bailwillharr/thecomputer/computer/docs/final_raytrace.png

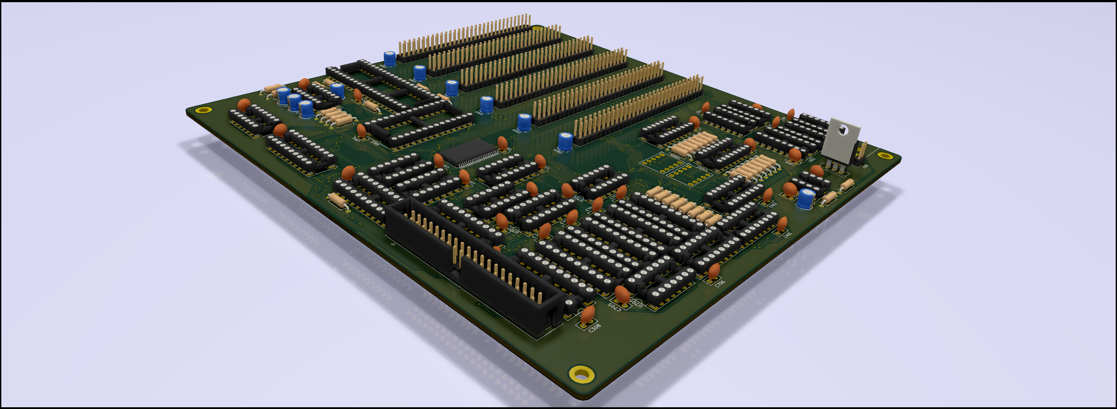
computer/docs/final_raytrace.png
