bailwillharr/thecomputer/computer/docs/final_raytrace3.png

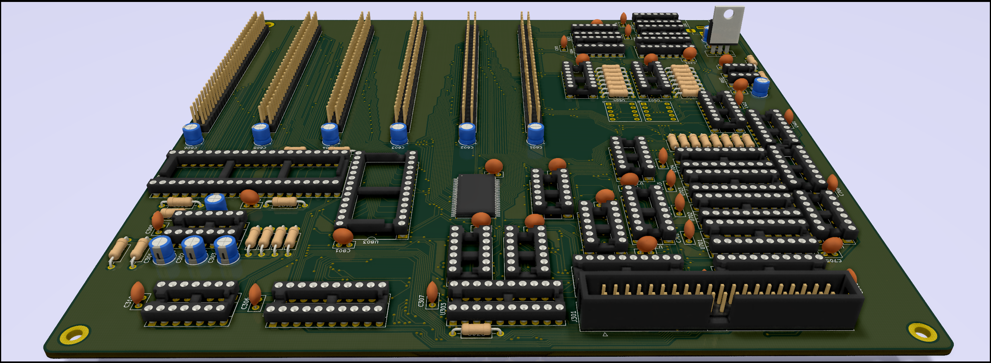
computer/docs/final_raytrace3.png
