bailwillharr/thecomputer/computer/docs/final_raytrace2.png

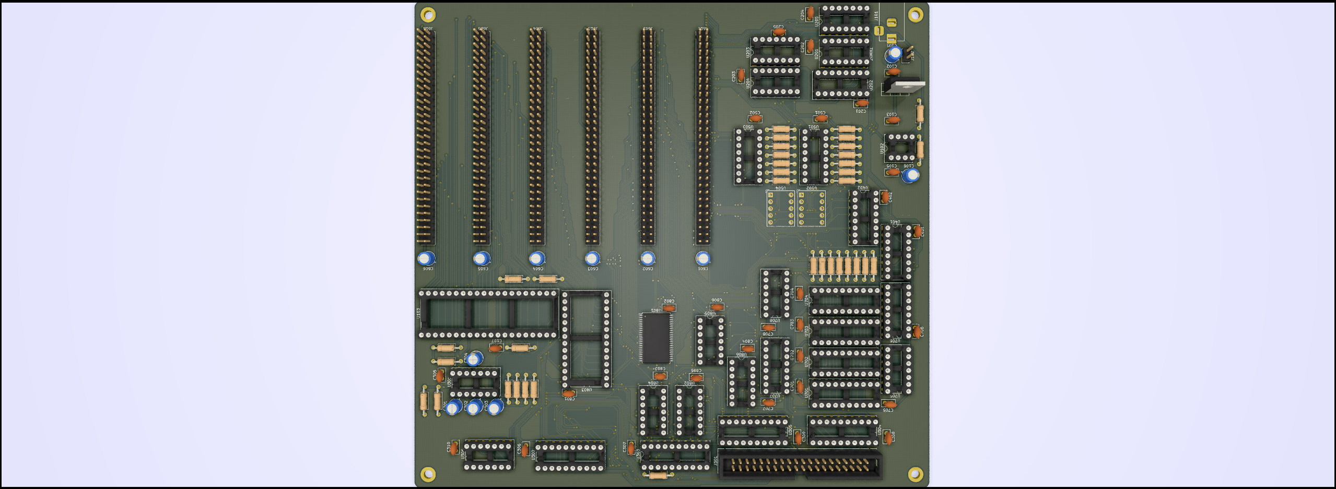
computer/docs/final_raytrace2.png
