bailwillharr/thecomputer/video/docs/plan.png

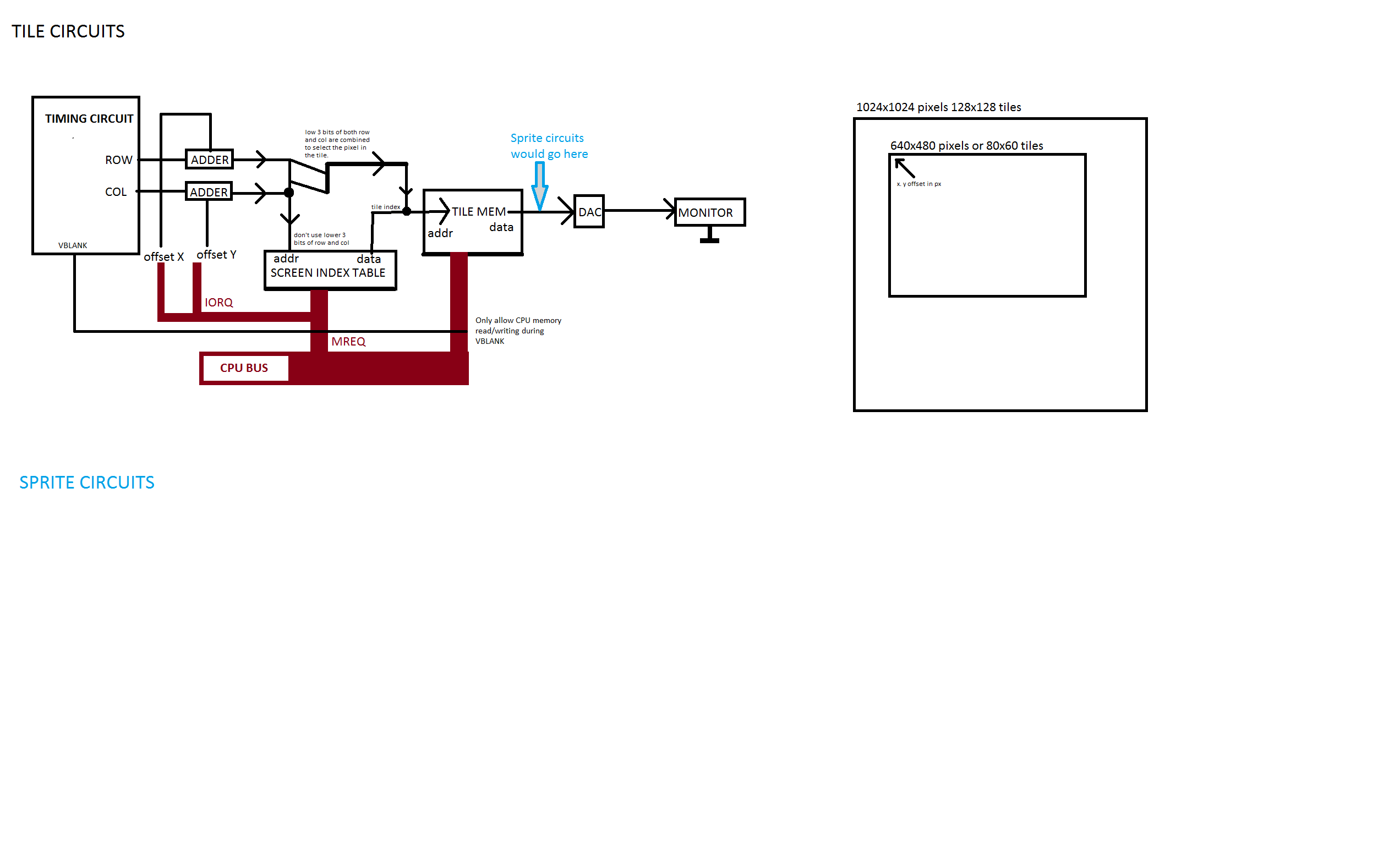
video/docs/plan.png
