bailwillharr/thecomputer/video/video.pdf

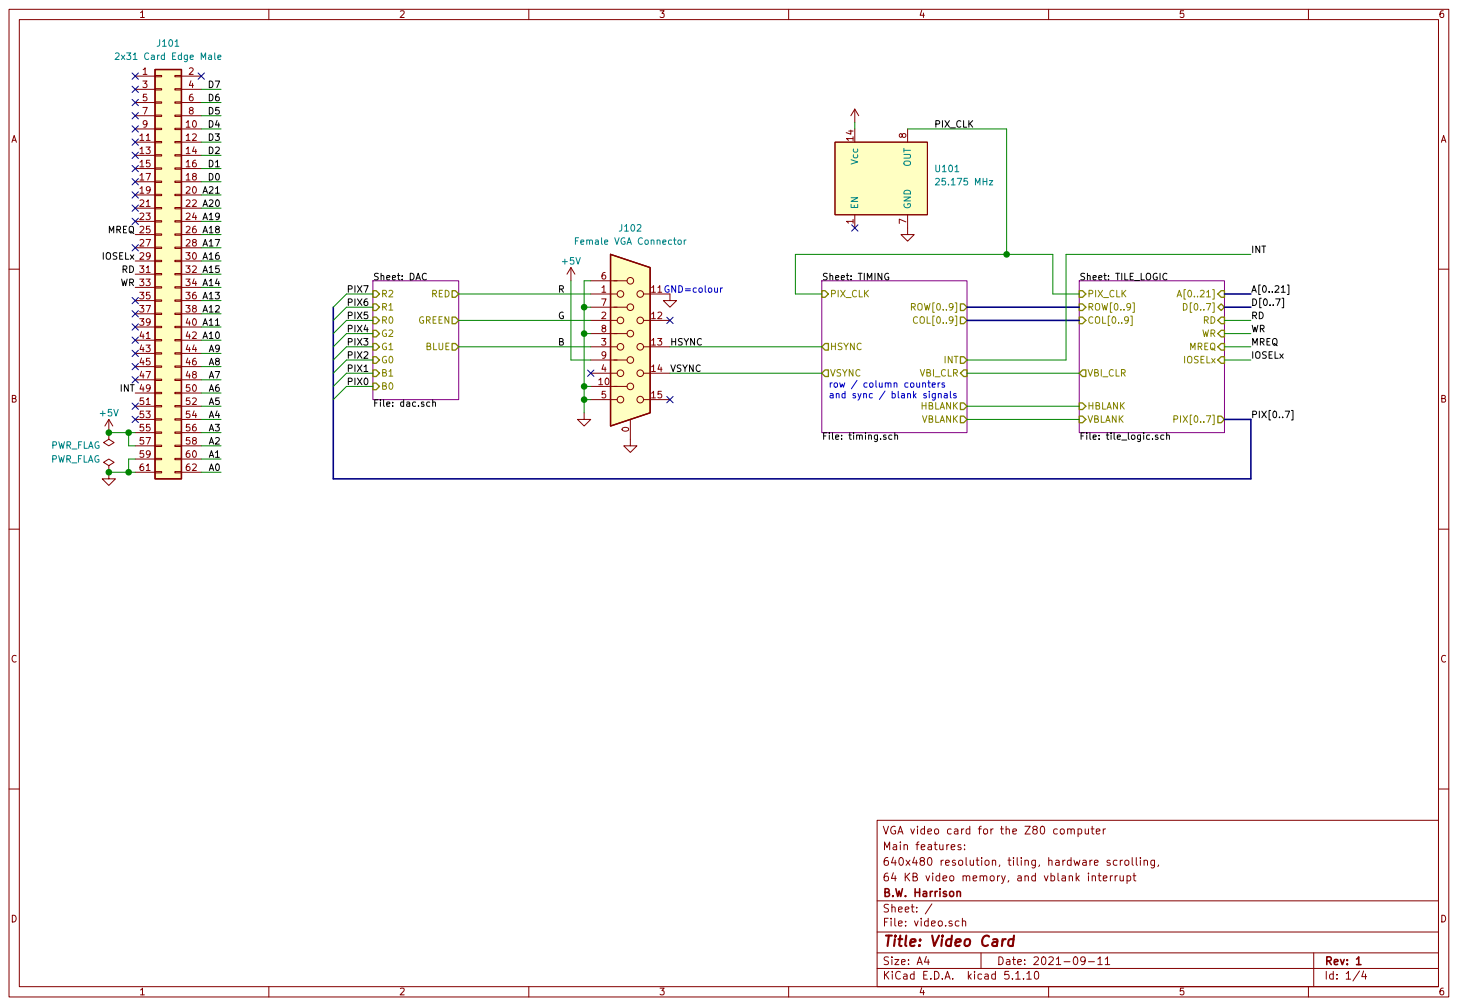
[picture p5: page 1]

row / column counters and sync / blank signals GND=colour

640x480 resolution, tiling, hardware scrolling, Main features: VGA video card for the Z80 computer

64 KB video memory, and vblank interrupt
File: video.sch Sheet: / B.W. Harrison

Id: 1/4 Title: Video Card

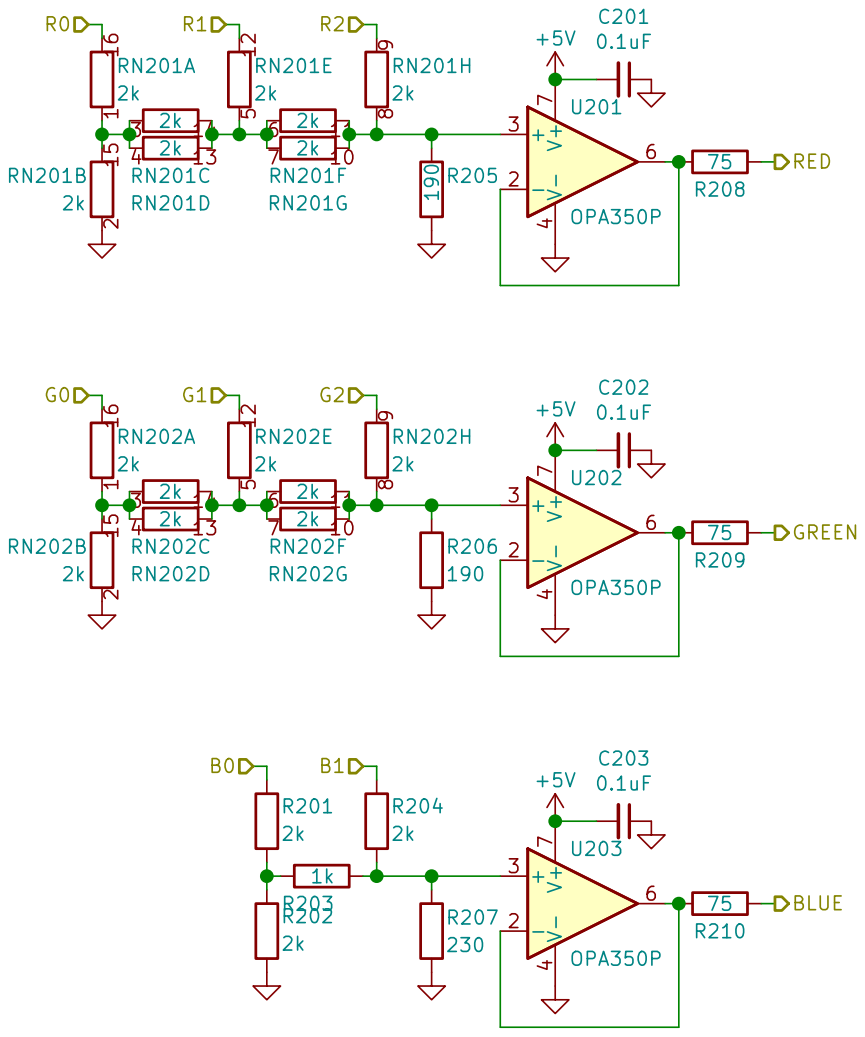
[picture p6: page 2]

Id: 2/4 Title: File: dac.sch Sheet: /DAC/ R204

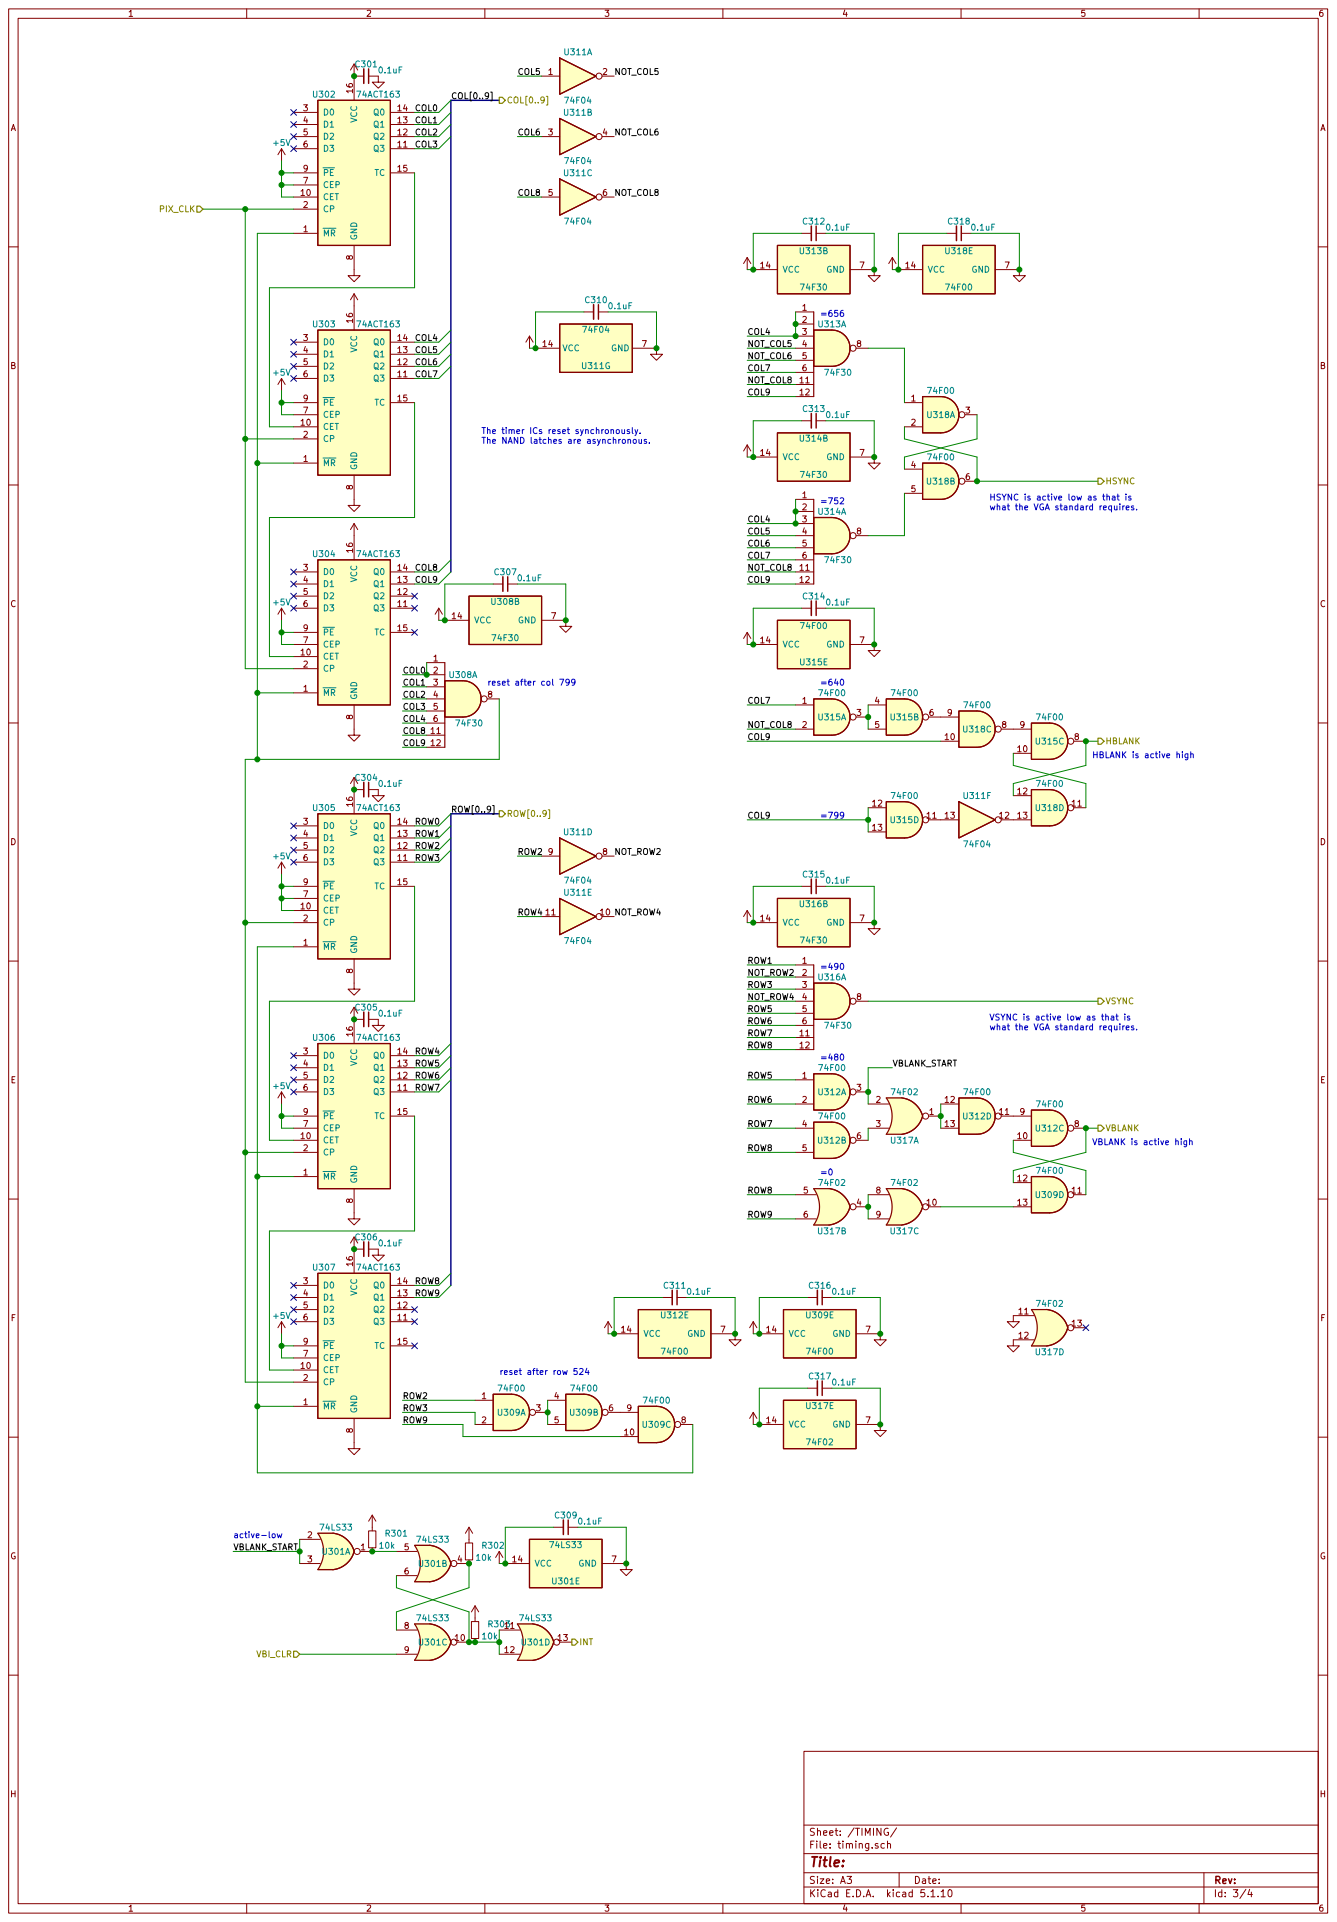
[picture p7: page 3]

8 PE 9 U302 74ACT163 MR 1 CET 10 Q3 11 Q2 12 Q1 13 Q0 14 TC 15 VCC 16 CP 2 D0 3 D1 4 D2 5 D3 6 CEP 7 GND

8 PE 9 U304 74ACT163 MR 1 CET 10 Q3 11 Q2 12 Q1 13 Q0 14 TC 15 VCC 16 CP 2 D0 3 D1 4 D2 5 D3 6 CEP 7 GND

8 PE 9 U306 74ACT163 MR 1 CET 10 Q3 11 Q2 12 Q1 13 Q0 14 TC 15 VCC 16 CP 2 D0 3 D1 4 D2 5 D3 6 CEP 7 GND

8 PE 9 U305 74ACT163 MR 1 CET 10 Q3 11 Q2 12 Q1 13 Q0 14 TC 15 VCC 16 CP 2 D0 3 D1 4 D2 5 D3 6 CEP 7 GND

Id: 3/4 Title: File: timing.sch Sheet: /TIMING/

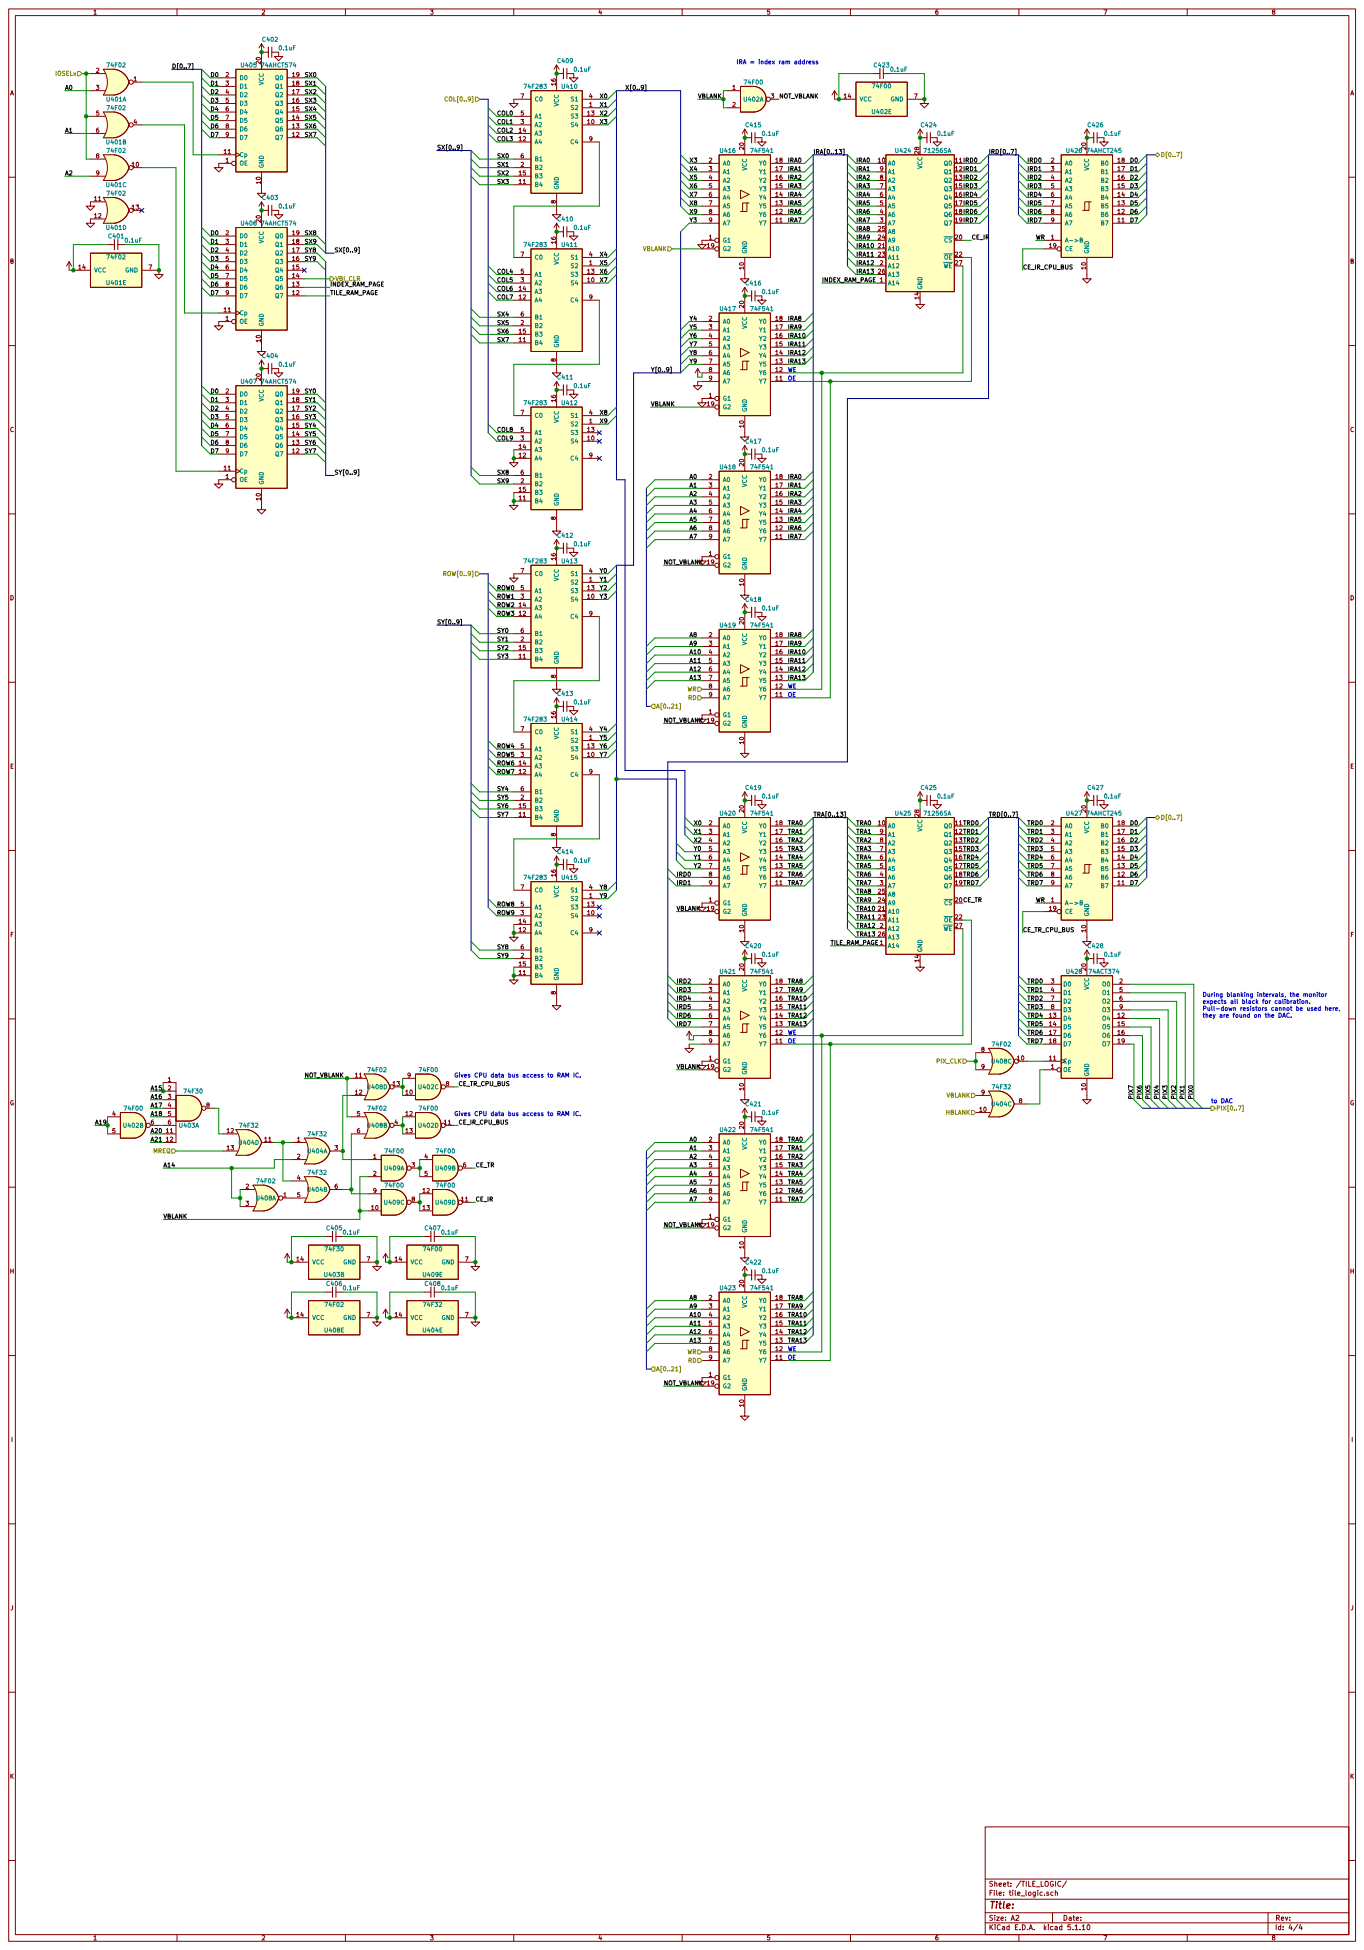
[picture p8: page 4]

IRA = index ram address

During blanking intervals, the monitor expects all black for calibration. Pull-down resistors cannot be used here,

they are found on the DAC. Gives CPU data bus access to RAM IC. Gives CPU data bus access to RAM IC.

to DAC WE OEWE OE

Id: 4/4 Title: File: tile_logic.sch Sheet: /TILE_LOGIC/
