bailwillharr/thecomputer/computer/pcb.pdf

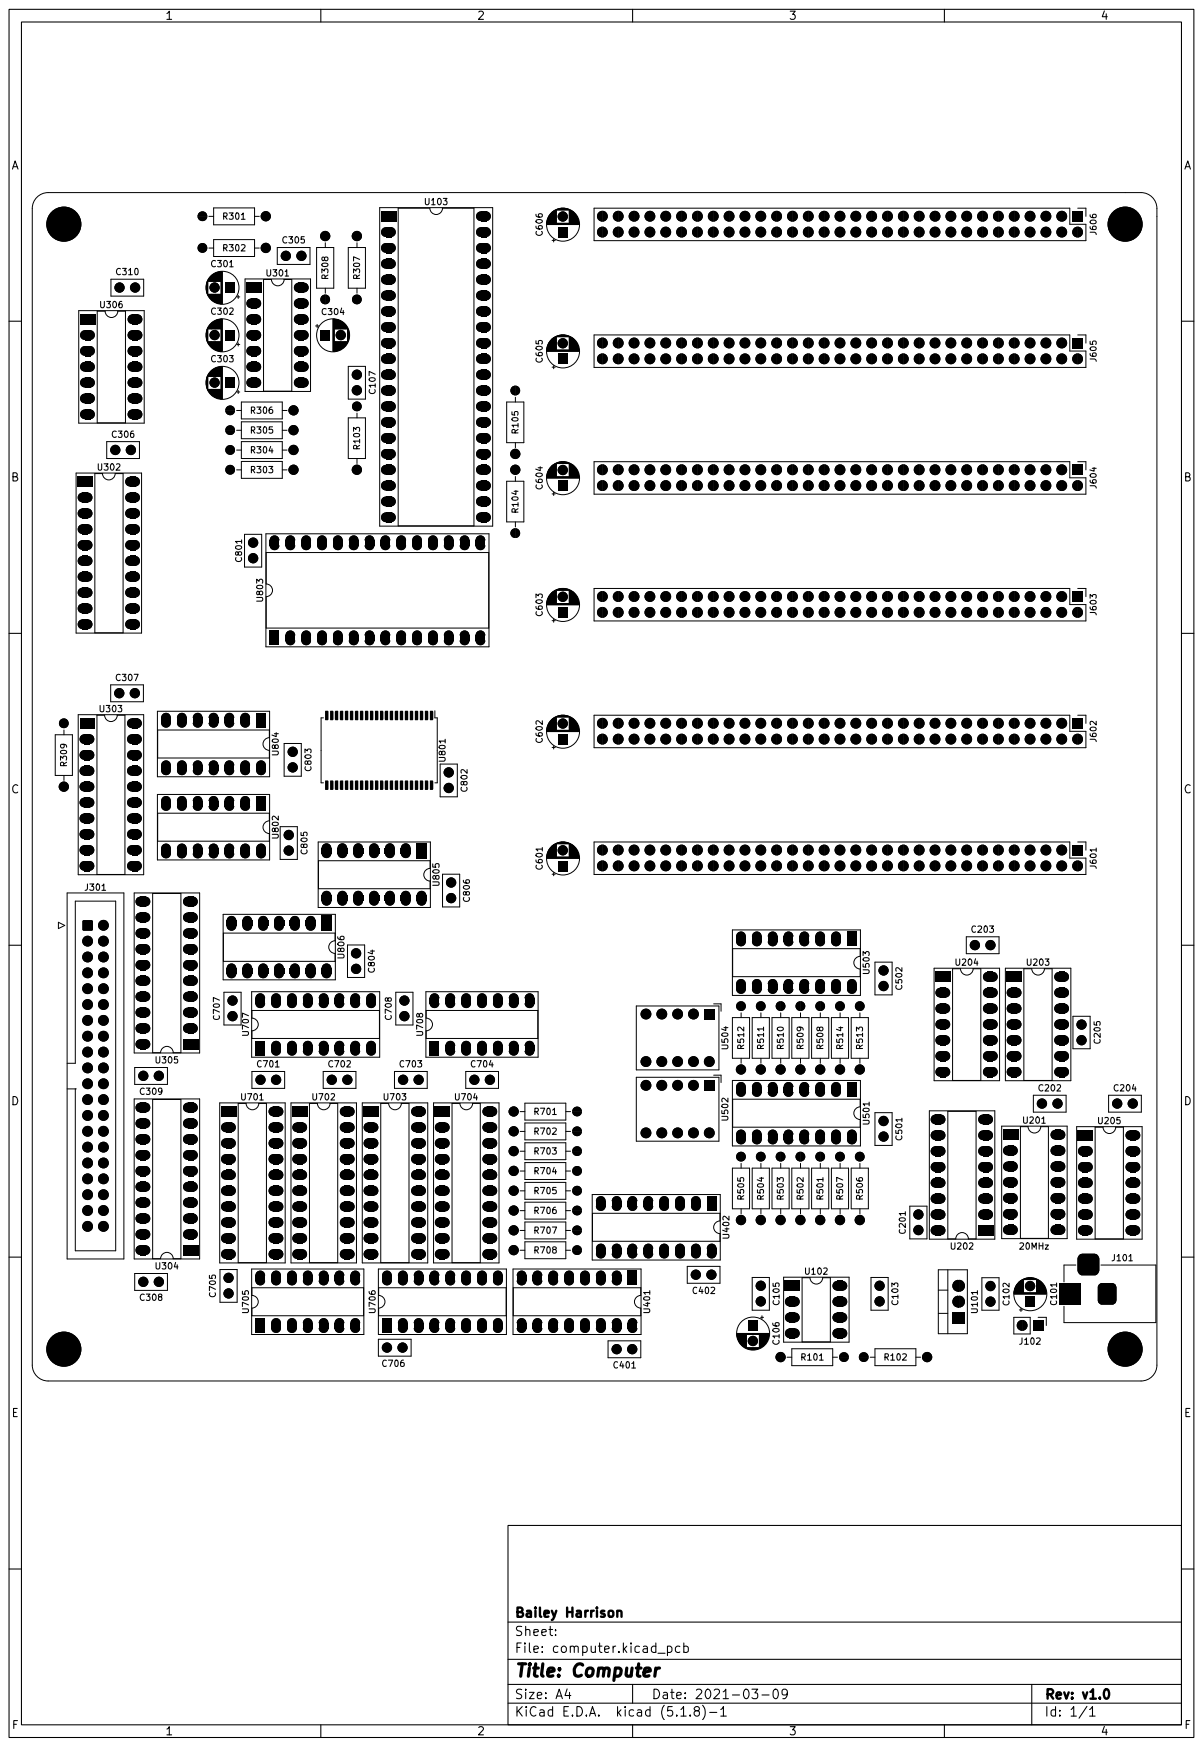
[picture p17: page 1]
