bailwillharr/thecomputer/video/video.kicad_pcb

## KiCad design video/video.kicad_pcb (2023-03-09)

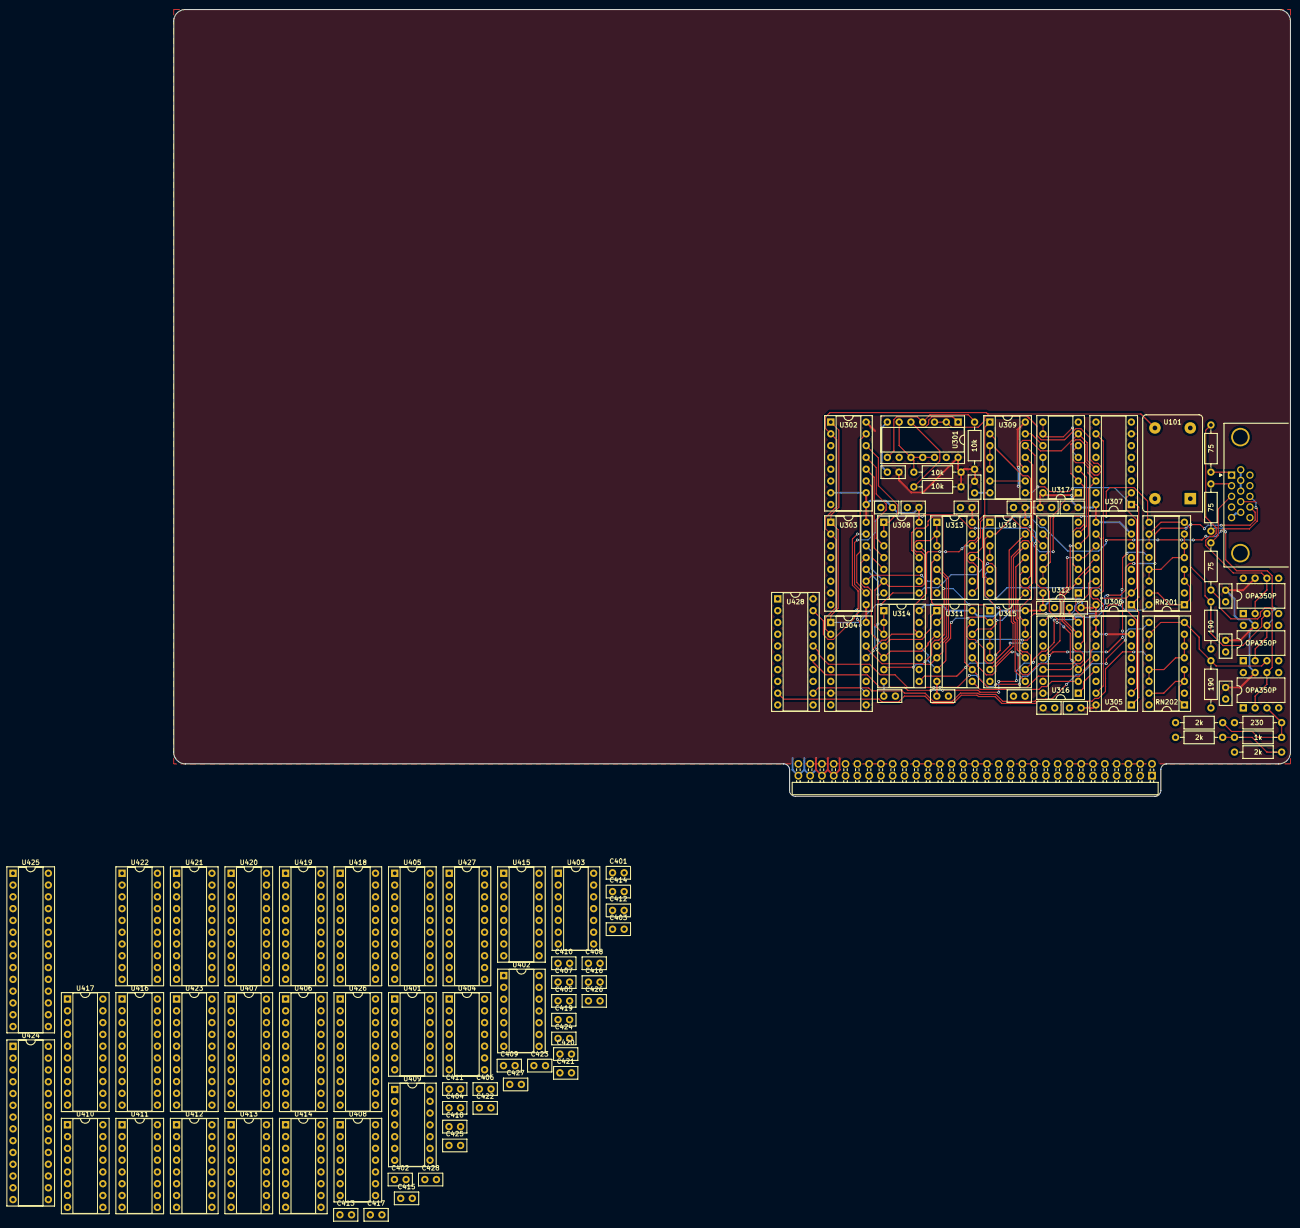
[picture p18: board video.kicad_pcb from above]

Board: 2 copper layers, 240.7 x 169.5 mm, 112 parts (0 on the bottom side), 213 nets.

Parts:
C201, C202, C203, C301, C304, C305, C306, C307, C309, C310, C311, C312, C313, C314, C315, C316, C317, C318, C401, C402, C403, C404, C405, C406, C407, C408, C409, C410, C411, C412, C413, C414, C415, C416, C417, C418, C419, C420, C421, C422, C423, C424, C425, C426, C427, C428: 0.1uF; C_Disc_D5.0mm_W2.5mm_P2.50mm
J101: 2x31 Card Edge Male; PinHeader_2x31_P2.54mm_Horizontal_AltPins
J102: Female VGA Connector; DSUB-15-HD_Female_Horizontal_P2.29x1.98mm_EdgePinOffset8.35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
R201, R202, R204: 2k; R_Axial_DIN0207_L6.3mm_D2.5mm_P10.16mm_Horizontal
R203: 1k; R_Axial_DIN0207_L6.3mm_D2.5mm_P10.16mm_Horizontal
R205, R206: 190; R_Axial_DIN0207_L6.3mm_D2.5mm_P10.16mm_Horizontal
R207: 230; R_Axial_DIN0207_L6.3mm_D2.5mm_P10.16mm_Horizontal
R208, R209, R210: 75; R_Axial_DIN0207_L6.3mm_D2.5mm_P10.16mm_Horizontal
R301, R302, R303: 10k; R_Axial_DIN0207_L6.3mm_D2.5mm_P10.16mm_Horizontal
RN201, RN202: 2k; DIP-16_W7.62mm_Socket
U101: 25.175 MHz; Oscillator_DIP-14_LargePads
U201, U202, U203: OPA350P; DIP-8_W7.62mm
U301: 74LS33; DIP-14_W7.62mm_Socket
U302, U303, U304, U305, U306, U307: 74ACT163; DIP-16_W7.62mm_Socket
U308, U313, U314, U316, U403: 74F30; DIP-14_W7.62mm_Socket
U309, U312, U315, U318, U402, U409: 74F00; DIP-14_W7.62mm_Socket
U311: 74F04; DIP-14_W7.62mm_Socket
U317, U401, U408: 74F02; DIP-14_W7.62mm_Socket
U404: 74F32; DIP-14_W7.62mm_Socket
U405, U406, U407: 74AHCT574; DIP-20_W7.62mm_Socket
U410, U411, U412, U413, U414, U415: 74F283; DIP-16_W7.62mm_Socket
U416, U417, U418, U419, U420, U421, U422, U423: 74F541; DIP-20_W7.62mm_Socket
U424, U425: 71256SA; DIP-28_W7.62mm_Socket
U426, U427: 74AHCT245; DIP-20_W7.62mm_Socket
U428: 74ACT374; DIP-20_W7.62mm_Socket

Connections:
+5V: C201.2, C202.2, C203.2, C301.2, C304.2, C305.2, C306.2, C307.2, C309.2, C310.2, C311.2, C312.2, C313.2, C314.2, C315.2, C316.2, C317.2, C318.2, C401.2, C402.2, C403.2, C404.2, C405.2, C406.2, C407.2, C408.2, C409.2, C410.2, C411.2, C412.2, C413.2, C414.2, C415.2, C416.2, C417.2, C418.2, C419.2, C420.2, C421.2, C422.2, C423.2, C424.2, C425.2, C426.2, C427.2, C428.2, J101.55, J101.57, J102.9, R301.1, R302.1, R303.1, U101.14 (Vcc), U201.7 (V+), U202.7 (V+), U203.7 (V+), U301.14 (VCC), U302.7 (CEP), U302.9 (~PE), U302.10 (CET), U302.16 (VCC), U303.7 (CEP), U303.9 (~PE), U303.16 (VCC), U304.7 (CEP), U304.9 (~PE), U304.16 (VCC), U305.7 (CEP), U305.9 (~PE), U305.10 (CET), U305.16 (VCC), U306.7 (CEP), U306.9 (~PE), U306.16 (VCC), U307.7 (CEP), U307.9 (~PE), U307.16 (VCC), U308.14 (VCC), U309.14 (VCC), U311.14 (VCC), U312.14 (VCC), U313.14 (VCC), U314.14 (VCC), U315.14 (VCC), U316.14 (VCC), U317.14 (VCC), U318.14 (VCC), U401.14 (VCC), U402.14 (VCC), U403.14 (VCC), U404.14 (VCC), U405.20 (VCC), U406.20 (VCC), U407.20 (VCC), U408.14 (VCC), U409.14 (VCC), U410.16 (VCC), U411.16 (VCC), U412.16 (VCC), U413.16 (VCC), U414.16 (VCC), U415.16 (VCC), U416.20 (VCC), U417.8 (A6), U417.20 (VCC), U418.20 (VCC), U419.20 (VCC), U420.20 (VCC), U421.8 (A6), U421.20 (VCC), U422.20 (VCC), U423.20 (VCC), U424.28 (VCC), U425.28 (VCC), U426.20 (VCC), U427.20 (VCC), U428.20 (VCC)
/A0: J101.62, U401.3, U418.2 (A0), U422.2 (A0)
/A1: J101.60, U401.6, U418.3 (A1), U422.3 (A1)
/A2: J101.58, U401.9, U418.4 (A2), U422.4 (A2)
/A3: J101.56, U418.5 (A3), U422.5 (A3)
/A4: J101.54, U418.6 (A4), U422.6 (A4)
/A5: J101.52, U418.7 (A5), U422.7 (A5)
/A6: J101.50, U418.8 (A6), U422.8 (A6)
/A7: J101.48, U418.9 (A7), U422.9 (A7)
/A8: J101.46, U419.2 (A0), U423.2 (A0)
/A9: J101.44, U419.3 (A1), U423.3 (A1)
/A10: J101.42, U419.4 (A2), U423.4 (A2)
/A11: J101.40, U419.5 (A3), U423.5 (A3)
/A12: J101.38, U419.6 (A4), U423.6 (A4)
/A13: J101.36, U419.7 (A5), U423.7 (A5)
/A14: J101.34, U404.2, U408.2, U408.3
/A15: J101.32, U403.1, U403.2
/A16: J101.30, U403.3
/A17: J101.28, U403.4
/A18: J101.26, U403.5
/A19: J101.24, U402.4, U402.5
/A20: J101.22, U403.11
/A21: J101.20, U403.12
/B: J102.3, R210.1
/D0: J101.18, U405.2 (D0), U406.2 (D0), U407.2 (D0), U426.18 (B0), U427.18 (B0)
/D1: J101.16, U405.3 (D1), U406.3 (D1), U407.3 (D1), U426.17 (B1), U427.17 (B1)
/D2: J101.14, U405.4 (D2), U406.4 (D2), U407.4 (D2), U426.16 (B2), U427.16 (B2)
/D3: J101.12, U405.5 (D3), U406.5 (D3), U407.5 (D3), U426.15 (B3), U427.15 (B3)
/D4: J101.10, U405.6 (D4), U406.6 (D4), U407.6 (D4), U426.14 (B4), U427.14 (B4)
/D5: J101.8, U405.7 (D5), U406.7 (D5), U407.7 (D5), U426.13 (B5), U427.13 (B5)
/D6: J101.6, U405.8 (D6), U406.8 (D6), U407.8 (D6), U426.12 (B6), U427.12 (B6)
/D7: J101.4, U405.9 (D7), U406.9 (D7), U407.9 (D7), U426.11 (B7), U427.11 (B7)
/G: J102.2, R209.1
/HSYNC: J102.13, U318.2, U318.6
/INT: J101.49, U301.13
/IOSELx: J101.29, U401.2, U401.5, U401.8
/MREQ: J101.25, U404.13
/PIX0: R201.2, U428.2 (O0)
/PIX1: R204.2, U428.5 (O1)
/PIX2: RN202.16 (R1.2), U428.6 (O2)
/PIX3: RN202.12 (R5.2), U428.9 (O3)
/PIX4: RN202.9 (R8.2), U428.12 (O4)
/PIX5: RN201.16 (R1.2), U428.15 (O5)
/PIX6: RN201.12 (R5.2), U428.16 (O6)
/PIX7: RN201.9 (R8.2), U428.19 (O7)
/PIX_CLK: U101.8 (OUT), U302.2 (CP), U303.2 (CP), U304.2 (CP), U408.8, U408.9
/R: J102.1, R208.1
/RD: J101.31, U419.9 (A7), U423.9 (A7)
/TILE_LOGIC/CE_IR: U409.11, U424.20 (~CS)
/TILE_LOGIC/CE_IR_CPU_BUS: U402.11, U426.19 (CE)
/TILE_LOGIC/CE_TR: U409.6, U425.20 (~CS)
/TILE_LOGIC/CE_TR_CPU_BUS: U402.8, U427.19 (CE)
/TILE_LOGIC/HBLANK: U315.8, U318.12, U404.10
/TILE_LOGIC/INDEX_RAM_PAGE: U406.13 (Q6), U424.1 (A14)
/TILE_LOGIC/IRA0: U416.18 (Y0), U418.18 (Y0), U424.10 (A0)
/TILE_LOGIC/IRA1: U416.17 (Y1), U418.17 (Y1), U424.9 (A1)
/TILE_LOGIC/IRA2: U416.16 (Y2), U418.16 (Y2), U424.8 (A2)
/TILE_LOGIC/IRA3: U416.15 (Y3), U418.15 (Y3), U424.7 (A3)
/TILE_LOGIC/IRA4: U416.14 (Y4), U418.14 (Y4), U424.6 (A4)
/TILE_LOGIC/IRA5: U416.13 (Y5), U418.13 (Y5), U424.5 (A5)
/TILE_LOGIC/IRA6: U416.12 (Y6), U418.12 (Y6), U424.4 (A6)
/TILE_LOGIC/IRA7: U416.11 (Y7), U418.11 (Y7), U424.3 (A7)
/TILE_LOGIC/IRA8: U417.18 (Y0), U419.18 (Y0), U424.25 (A8)
/TILE_LOGIC/IRA9: U417.17 (Y1), U419.17 (Y1), U424.24 (A9)
/TILE_LOGIC/IRA10: U417.16 (Y2), U419.16 (Y2), U424.21 (A10)
/TILE_LOGIC/IRA11: U417.15 (Y3), U419.15 (Y3), U424.23 (A11)
/TILE_LOGIC/IRA12: U417.14 (Y4), U419.14 (Y4), U424.2 (A12)
/TILE_LOGIC/IRA13: U417.13 (Y5), U419.13 (Y5), U424.26 (A13)
/TILE_LOGIC/IRD0: U420.8 (A6), U424.11 (Q0), U426.2 (A0)
/TILE_LOGIC/IRD1: U420.9 (A7), U424.12 (Q1), U426.3 (A1)
/TILE_LOGIC/IRD2: U421.2 (A0), U424.13 (Q2), U426.4 (A2)
/TILE_LOGIC/IRD3: U421.3 (A1), U424.15 (Q3), U426.5 (A3)
/TILE_LOGIC/IRD4: U421.4 (A2), U424.16 (Q4), U426.6 (A4)
/TILE_LOGIC/IRD5: U421.5 (A3), U424.17 (Q5), U426.7 (A5)
/TILE_LOGIC/IRD6: U421.6 (A4), U424.18 (Q6), U426.8 (A6)
/TILE_LOGIC/IRD7: U421.7 (A5), U424.19 (Q7), U426.9 (A7)
/TILE_LOGIC/NOT_VBLANK: U402.3, U408.5, U408.11, U418.19 (G2), U419.19 (G2), U422.19 (G2), U423.19 (G2)
/TILE_LOGIC/SX0: U405.19 (Q0), U410.6 (B1)
/TILE_LOGIC/SX1: U405.18 (Q1), U410.2 (B2)
/TILE_LOGIC/SX2: U405.17 (Q2), U410.15 (B3)
/TILE_LOGIC/SX3: U405.16 (Q3), U410.11 (B4)
/TILE_LOGIC/SX4: U405.15 (Q4), U411.6 (B1)
/TILE_LOGIC/SX5: U405.14 (Q5), U411.2 (B2)
/TILE_LOGIC/SX6: U405.13 (Q6), U411.15 (B3)
/TILE_LOGIC/SX7: U405.12 (Q7), U411.11 (B4)
/TILE_LOGIC/SX8: U406.19 (Q0), U412.6 (B1)
/TILE_LOGIC/SX9: U406.18 (Q1), U412.2 (B2)
/TILE_LOGIC/SY0: U407.19 (Q0), U413.6 (B1)
/TILE_LOGIC/SY1: U407.18 (Q1), U413.2 (B2)
/TILE_LOGIC/SY2: U407.17 (Q2), U413.15 (B3)
/TILE_LOGIC/SY3: U407.16 (Q3), U413.11 (B4)
/TILE_LOGIC/SY4: U407.15 (Q4), U414.6 (B1)
/TILE_LOGIC/SY5: U407.14 (Q5), U414.2 (B2)
/TILE_LOGIC/SY6: U407.13 (Q6), U414.15 (B3)
/TILE_LOGIC/SY7: U407.12 (Q7), U414.11 (B4)
/TILE_LOGIC/SY8: U406.17 (Q2), U415.6 (B1)
/TILE_LOGIC/SY9: U406.16 (Q3), U415.2 (B2)
/TILE_LOGIC/TILE_RAM_PAGE: U406.12 (Q7), U425.1 (A14)
/TILE_LOGIC/TRA0: U420.18 (Y0), U422.18 (Y0), U425.10 (A0)
/TILE_LOGIC/TRA1: U420.17 (Y1), U422.17 (Y1), U425.9 (A1)
/TILE_LOGIC/TRA2: U420.16 (Y2), U422.16 (Y2), U425.8 (A2)
/TILE_LOGIC/TRA3: U420.15 (Y3), U422.15 (Y3), U425.7 (A3)
/TILE_LOGIC/TRA4: U420.14 (Y4), U422.14 (Y4), U425.6 (A4)
/TILE_LOGIC/TRA5: U420.13 (Y5), U422.13 (Y5), U425.5 (A5)
/TILE_LOGIC/TRA6: U420.12 (Y6), U422.12 (Y6), U425.4 (A6)
/TILE_LOGIC/TRA7: U420.11 (Y7), U422.11 (Y7), U425.3 (A7)
/TILE_LOGIC/TRA8: U421.18 (Y0), U423.18 (Y0), U425.25 (A8)
/TILE_LOGIC/TRA9: U421.17 (Y1), U423.17 (Y1), U425.24 (A9)
/TILE_LOGIC/TRA10: U421.16 (Y2), U423.16 (Y2), U425.21 (A10)
/TILE_LOGIC/TRA11: U421.15 (Y3), U423.15 (Y3), U425.23 (A11)
/TILE_LOGIC/TRA12: U421.14 (Y4), U423.14 (Y4), U425.2 (A12)
/TILE_LOGIC/TRA13: U421.13 (Y5), U423.13 (Y5), U425.26 (A13)
/TILE_LOGIC/TRD0: U425.11 (Q0), U427.2 (A0), U428.3 (D0)
/TILE_LOGIC/TRD1: U425.12 (Q1), U427.3 (A1), U428.4 (D1)
/TILE_LOGIC/TRD2: U425.13 (Q2), U427.4 (A2), U428.7 (D2)
/TILE_LOGIC/TRD3: U425.15 (Q3), U427.5 (A3), U428.8 (D3)
/TILE_LOGIC/TRD4: U425.16 (Q4), U427.6 (A4), U428.13 (D4)
/TILE_LOGIC/TRD5: U425.17 (Q5), U427.7 (A5), U428.14 (D5)
/TILE_LOGIC/TRD6: U425.18 (Q6), U427.8 (A6), U428.17 (D6)
/TILE_LOGIC/TRD7: U425.19 (Q7), U427.9 (A7), U428.18 (D7)
/TILE_LOGIC/VBI_CLR: U301.9, U406.14 (Q5)
/TILE_LOGIC/VBLANK: U309.12, U312.8, U402.1, U402.2, U404.9, U409.2, U409.10, U416.19 (G2), U417.19 (G2), U420.19 (G2), U421.19 (G2)
/TILE_LOGIC/X0: U410.4 (S1), U420.2 (A0)
/TILE_LOGIC/X1: U410.1 (S2), U420.3 (A1)
/TILE_LOGIC/X2: U410.13 (S3), U420.4 (A2)
/TILE_LOGIC/X3: U410.10 (S4), U416.2 (A0)
/TILE_LOGIC/X4: U411.4 (S1), U416.3 (A1)
/TILE_LOGIC/X5: U411.1 (S2), U416.4 (A2)
/TILE_LOGIC/X6: U411.13 (S3), U416.5 (A3)
/TILE_LOGIC/X7: U411.10 (S4), U416.6 (A4)
/TILE_LOGIC/X8: U412.4 (S1), U416.7 (A5)
/TILE_LOGIC/X9: U412.1 (S2), U416.8 (A6)
/TILE_LOGIC/Y0: U413.4 (S1), U420.5 (A3)
/TILE_LOGIC/Y1: U413.1 (S2), U420.6 (A4)
/TILE_LOGIC/Y2: U413.13 (S3), U420.7 (A5)
/TILE_LOGIC/Y3: U413.10 (S4), U416.9 (A7)
/TILE_LOGIC/Y4: U414.4 (S1), U417.2 (A0)
/TILE_LOGIC/Y5: U414.1 (S2), U417.3 (A1)
/TILE_LOGIC/Y6: U414.13 (S3), U417.4 (A2)
/TILE_LOGIC/Y7: U414.10 (S4), U417.5 (A3)
/TILE_LOGIC/Y8: U415.4 (S1), U417.6 (A4)
/TILE_LOGIC/Y9: U415.1 (S2), U417.7 (A5)
/TIMING/COL0: U308.1, U308.2, U410.5 (A1)
/TIMING/COL1: U308.3, U410.3 (A2)
/TIMING/COL2: U308.4, U410.14 (A3)
/TIMING/COL3: U308.5, U410.12 (A4)
/TIMING/COL4: U308.6, U313.1, U313.2, U313.3, U314.1, U314.2, U314.3, U411.5 (A1)
/TIMING/COL5: U311.1, U314.4, U411.3 (A2)
/TIMING/COL6: U311.3, U314.5, U411.14 (A3)
/TIMING/COL7: U313.6, U314.6, U315.1, U411.12 (A4)
/TIMING/COL8: U308.11, U311.5, U412.5 (A1)
/TIMING/COL9: U308.12, U313.12, U314.12, U315.12, U315.13, U318.10, U412.3 (A2)
/TIMING/NOT_COL5: U311.2, U313.4
/TIMING/NOT_COL6: U311.4, U313.5
/TIMING/NOT_COL8: U311.6, U313.11, U314.11, U315.2
/TIMING/NOT_ROW2: U311.8, U316.2
/TIMING/NOT_ROW4: U311.10, U316.4
/TIMING/ROW1: U316.1, U413.3 (A2)
/TIMING/ROW2: U309.1, U311.9, U413.14 (A3)
/TIMING/ROW3: U309.2, U316.3, U413.12 (A4)
/TIMING/ROW4: U311.11, U414.5 (A1)
/TIMING/ROW5: U312.1, U316.5, U414.3 (A2)
/TIMING/ROW6: U312.2, U316.6, U414.14 (A3)
/TIMING/ROW7: U312.4, U316.11, U414.12 (A4)
/TIMING/ROW8: U312.5, U316.12, U317.5, U415.5 (A1)
/TIMING/ROW9: U309.10, U317.6, U415.3 (A2)
/TIMING/VBLANK_START: U301.2, U301.3, U312.3, U317.2
/VSYNC: J102.14, U316.8
/WR: J101.33, U419.8 (A6), U423.8 (A6), U426.1 (A->B), U427.1 (A->B)
GND: C201.1, C202.1, C203.1, C301.1, C304.1, C305.1, C306.1, C307.1, C309.1, C310.1, C311.1, C312.1, C313.1, C314.1, C315.1, C316.1, C317.1, C318.1, C401.1, C402.1, C403.1, C404.1, C405.1, C406.1, C407.1, C408.1, C409.1, C410.1, C411.1, C412.1, C413.1, C414.1, C415.1, C416.1, C417.1, C418.1, C419.1, C420.1, C421.1, C422.1, C423.1, C424.1, C425.1, C426.1, C427.1, C428.1, J101.59, J101.61, J102.0, J102.5, J102.6, J102.7, J102.8, J102.10, J102.11, R202.1, R205.2, R206.2, R207.2, RN201.2 (R2.1), RN202.2 (R2.1), U101.7 (GND), U201.4 (V-), U202.4 (V-), U203.4 (V-), U301.7 (GND), U302.8 (GND), U303.8 (GND), U304.8 (GND), U305.8 (GND), U306.8 (GND), U307.8 (GND), U308.7 (GND), U309.7 (GND), U311.7 (GND), U312.7 (GND), U313.7 (GND), U314.7 (GND), U315.7 (GND), U316.7 (GND), U317.7 (GND), U317.11, U317.12, U318.7 (GND), U401.7 (GND), U401.11, U401.12, U402.7 (GND), U403.7 (GND), U404.7 (GND), U405.1 (OE), U405.10 (GND), U406.1 (OE), U406.10 (GND), U407.1 (OE), U407.10 (GND), U408.7 (GND), U409.7 (GND), U410.7 (C0), U410.8 (GND), U411.8 (GND), U412.8 (GND), U412.11 (B4), U412.12 (A4), U412.14 (A3), U412.15 (B3), U413.7 (C0), U413.8 (GND), U414.8 (GND), U415.8 (GND), U415.11 (B4), U415.12 (A4), U415.14 (A3), U415.15 (B3), U416.1 (G1), U416.10 (GND), U417.1 (G1), U417.9 (A7), U417.10 (GND), U418.1 (G1), U418.10 (GND), U419.1 (G1), U419.10 (GND), U420.1 (G1), U420.10 (GND), U421.1 (G1), U421.9 (A7), U421.10 (GND), U422.1 (G1), U422.10 (GND), U423.1 (G1), U423.10 (GND), U424.14 (GND), U425.14 (GND), U426.10 (GND), U427.10 (GND), U428.10 (GND)
unnamed: R201.1, R202.2, R203.2
unnamed: R301.2, U301.1, U301.5
unnamed: R302.2, U301.4, U301.8
unnamed: R303.2, U301.6, U301.10, U301.11, U301.12
unnamed: RN201.8 (R8.1), RN201.10 (R7.2), RN201.11 (R6.2), U201.3 (+)
unnamed: RN202.8 (R8.1), RN202.10 (R7.2), RN202.11 (R6.2), U202.3 (+)
unnamed: U201.2 (-), U201.6
unnamed: U202.2 (-), U202.6
unnamed: R204.1, R207.1, U203.3 (+)
unnamed: U203.2 (-), U203.6
unnamed: U303.1 (~MR), U304.1 (~MR), U305.2 (CP), U306.2 (CP), U307.2 (CP), U308.8
unnamed: U306.1 (~MR), U307.1 (~MR), U309.8
unnamed: U309.3, U309.4, U309.5
unnamed: U309.6, U309.9
unnamed: U309.11, U312.10
unnamed: U309.13, U317.10
unnamed: U311.12, U318.13
unnamed: U311.13, U315.11
unnamed: U312.6, U317.3
unnamed: U312.9, U312.11
unnamed: U312.12, U312.13, U317.1
unnamed: U313.8, U318.1
unnamed: U314.8, U318.5
unnamed: U315.3, U315.4, U315.5
unnamed: U315.6, U318.9
unnamed: U315.9, U318.8
unnamed: U315.10, U318.11
unnamed: U317.4, U317.8, U317.9
unnamed: U318.3, U318.4
unnamed: U402.6, U403.6
unnamed: U402.9, U402.10, U408.13
unnamed: U402.12, U402.13, U408.4
unnamed: U403.8, U404.12
unnamed: U404.1, U404.4, U404.11
unnamed: U404.3, U408.12, U409.1
unnamed: U404.5, U408.1
unnamed: U404.6, U408.6, U409.9
unnamed: U409.3, U409.4, U409.5
unnamed: U409.8, U409.12, U409.13
unnamed: U419.12 (Y6), U424.27 (~WE)
unnamed: U419.11 (Y7), U424.22 (~OE)
unnamed: U423.12 (Y6), U425.27 (~WE)
unnamed: U423.11 (Y7), U425.22 (~OE)
