bailwillharr/thecomputer/uart/uart.kicad_pcb

## KiCad design uart/uart.kicad_pcb (2023-03-07)

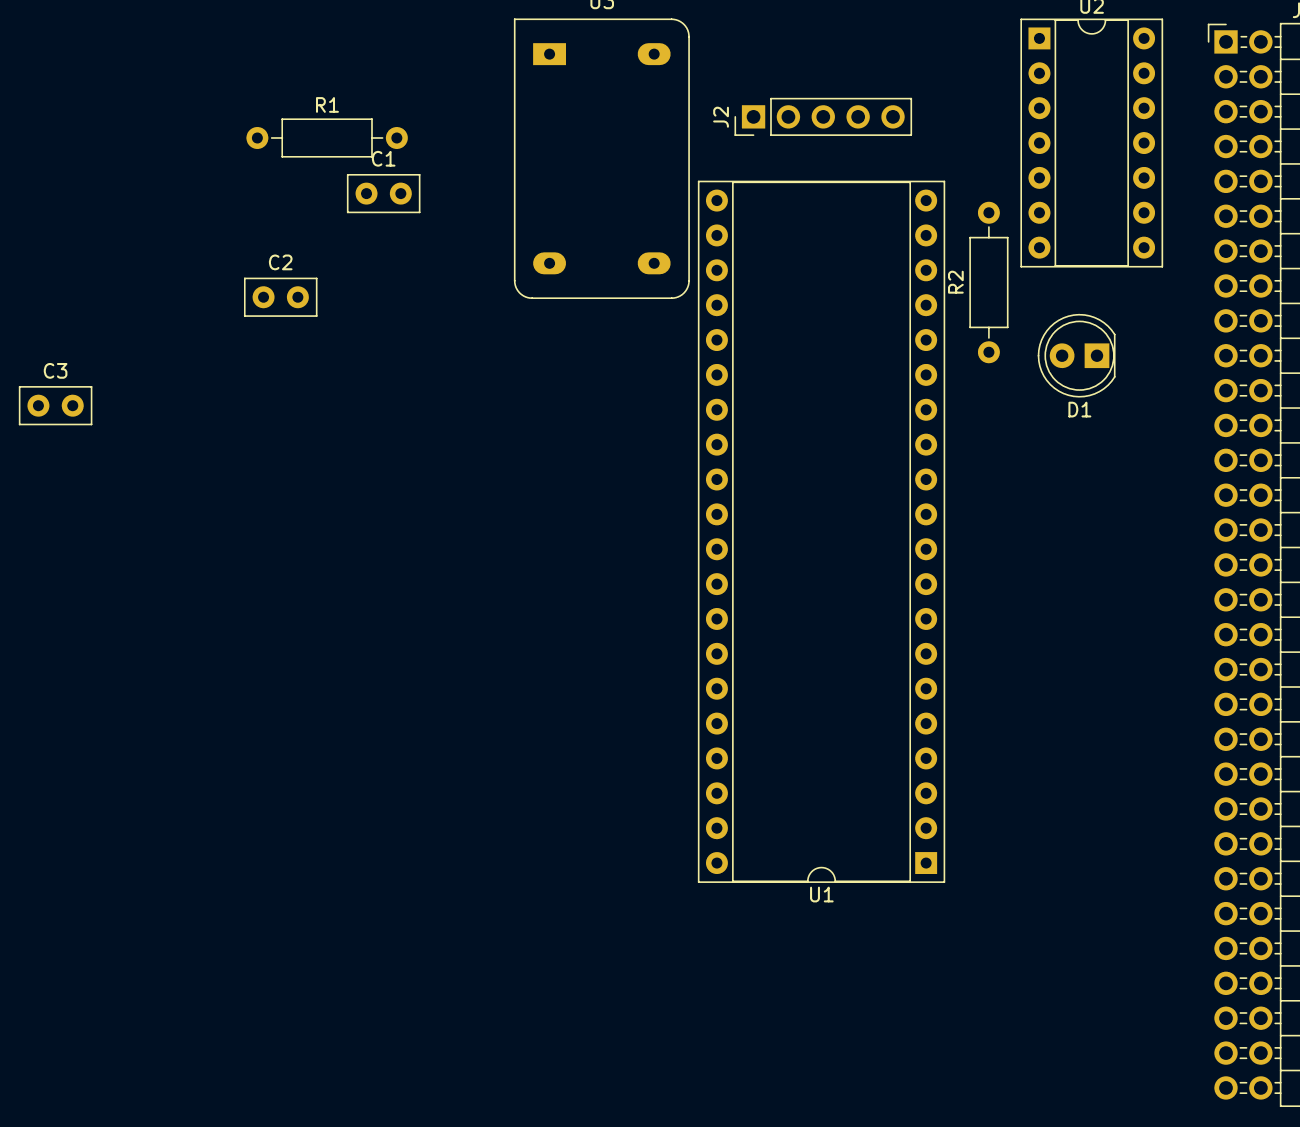
[picture p19: board uart.kicad_pcb from above]

Board: 2 copper layers, 11 parts (0 on the bottom side), 28 nets, no tracks yet.

Parts:
C1, C2, C3: 0.1µF; C_Disc_D5.0mm_W2.5mm_P2.50mm
D1: LED; LED_D5.0mm
J1: 2x31 Connector Cardside; PinHeader_2x31_P2.54mm_Horizontal
J2: 1x5 Connector Female; PinHeader_1x05_P2.54mm_Vertical
R1: 10k; R_Axial_DIN0207_L6.3mm_D2.5mm_P10.16mm_Horizontal
R2: 330; R_Axial_DIN0207_L6.3mm_D2.5mm_P10.16mm_Horizontal
U1: TL16C550CN; DIP-40_W15.24mm_Socket
U2: 74LS05; DIP-14_W7.62mm_Socket
U3: 16MHz; DIP-14_CornersOnly_Crystal

Connections:
+5V: C1.2, C2.2, C3.2, J1.56, J1.58, R1.1, R2.1, U1.12, U1.13, U1.40, U2.14, U3.1, U3.14
/A0: J1.61, U1.28
/A1: J1.59, U1.27
/A2: J1.57, U1.26
/CTS: J2.1, U1.36
/D0: J1.17, U1.1
/D1: J1.15, U1.2
/D2: J1.13, U1.3
/D3: J1.11, U1.4
/D4: J1.9, U1.5
/D5: J1.7, U1.6
/D6: J1.5, U1.7
/D7: J1.3, U1.8
/HALT: J1.10, U2.5
/INT: J1.50, U2.2
/IOSELx: J1.30, U1.14
/RD: J1.32, U1.21
/RST: J1.4, U2.3
/RTS: J2.2, U1.32
/RX: J2.4, U1.10
/TX: J2.3, U1.11
/WR: J1.34, U1.18
GND: C1.1, C2.1, C3.1, D1.1, J1.60, J1.62, J2.5, U1.19, U1.20, U1.22, U1.25, U1.37, U1.38, U1.39, U2.7, U2.9, U2.11, U2.13, U3.7
unnamed: D1.2, R2.2, U2.6
unnamed: R1.2, U1.35, U2.4
unnamed: U1.9, U1.15
unnamed: U1.16, U3.8
unnamed: U1.30, U2.1
