bailwillharr/thecomputer/computer/computer.kicad_pcb

## KiCad design computer/computer.kicad_pcb (2023-03-07)

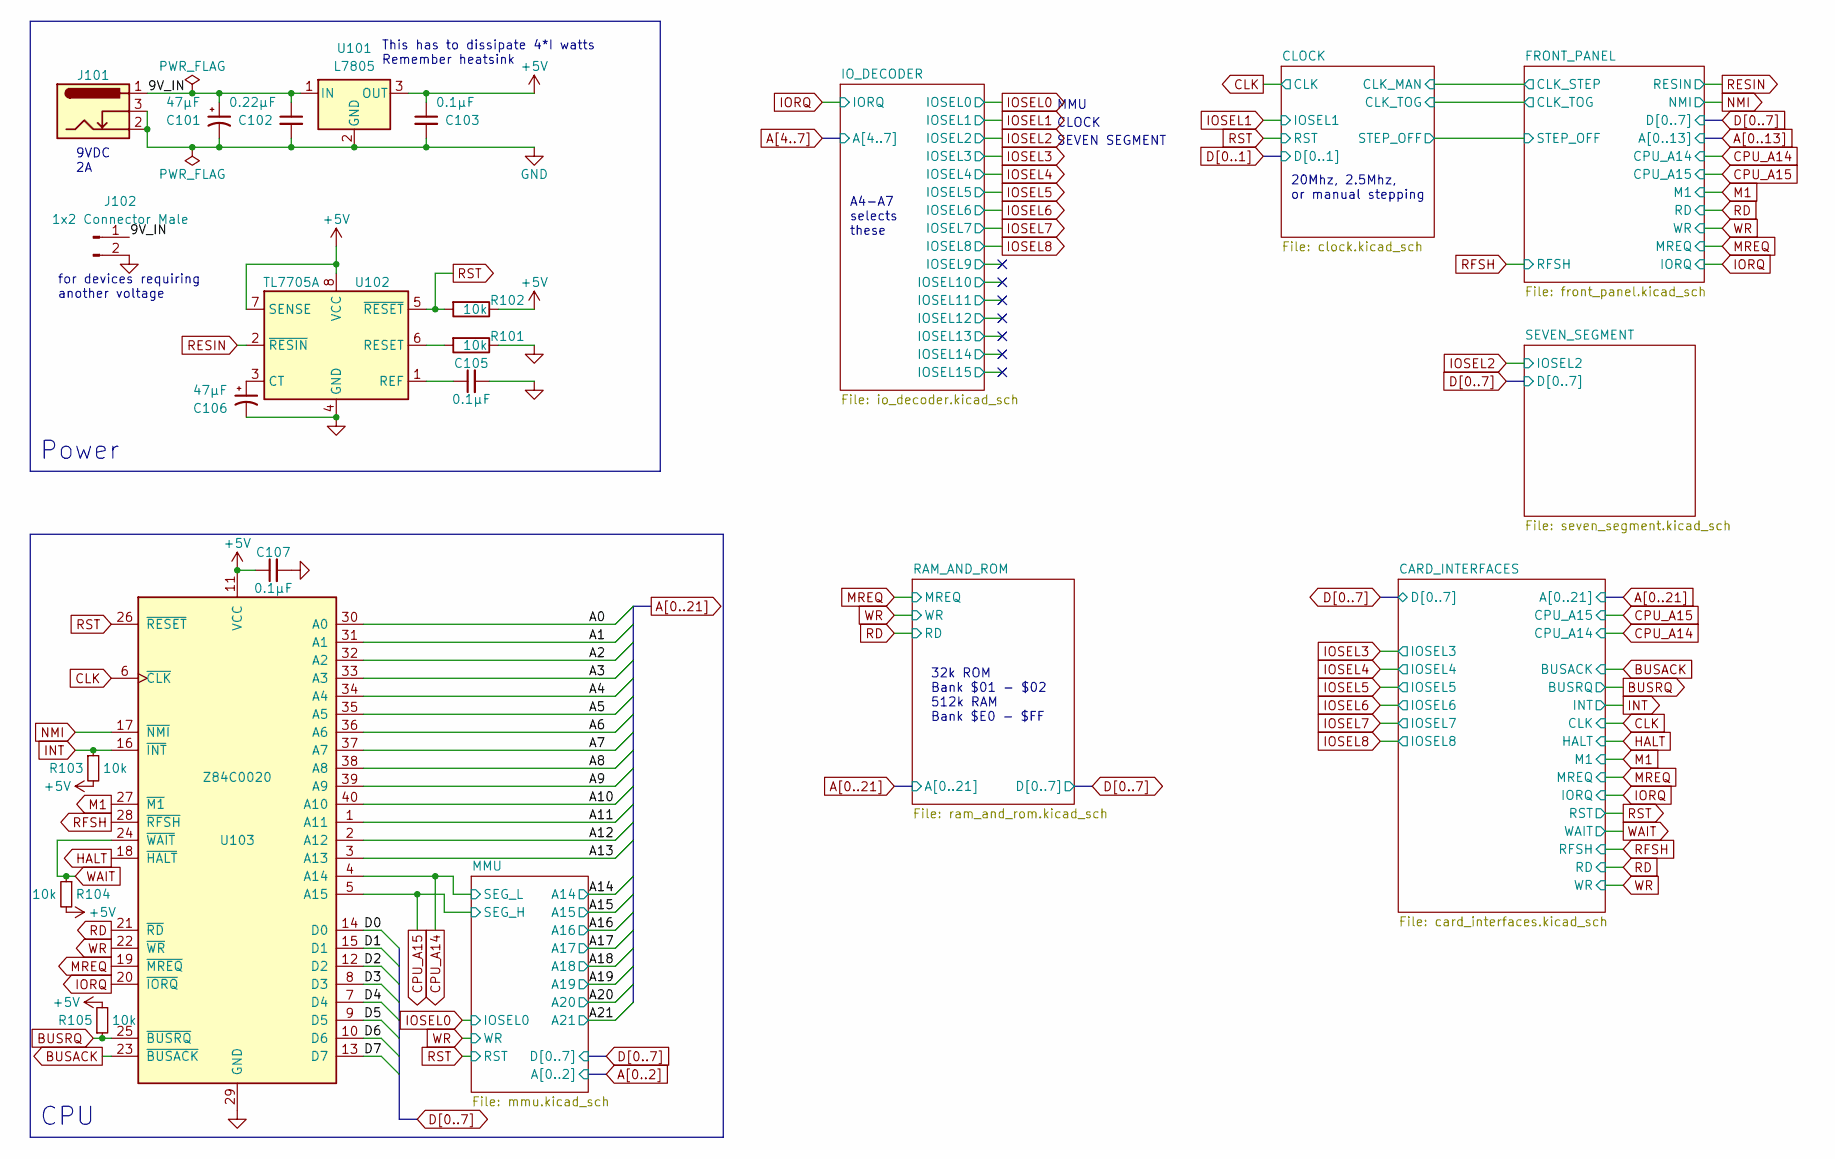
[picture p20: schematic computer.kicad_sch]

Parts:
C101, C106: 47µF; CP_Radial_D5.0mm_P2.50mm
C102: 0.22µF; C_Disc_D5.0mm_W2.5mm_P2.50mm
C103, C105, C107: 0.1µF; C_Disc_D5.0mm_W2.5mm_P2.50mm
J101: Barrel_Jack_Switch; BarrelJack_Horizontal
J102: 1x2 Connector Male; PinHeader_1x02_P2.54mm_Vertical
R101, R102, R103, R104, R105: 10k; R_Axial_DIN0207_L6.3mm_D2.5mm_P10.16mm_Horizontal
U101: L7805; TO-220-3_Vertical
U102: TL7705A; DIP-8_W7.62mm_Socket_LongPads
U103: Z84C0020; DIP-40_W15.24mm_Socket_LongPads

Connections:
+5V: C103.1, C107.1, R102.1, R103.2, R104.2, R105.2, U101.3 (OUT), U102.7 (SENSE), U102.8 (VCC), U103.11 (VCC); also elsewhere on the board
/9V_IN: C101.1, C102.1, J101.1, J102.1, U101.1 (IN)
A0: U103.30 (A0); also elsewhere on the board
A1: U103.31 (A1); also elsewhere on the board
A2: U103.32 (A2); also elsewhere on the board
A3: U103.33 (A3); also elsewhere on the board
A4: U103.34 (A4); also elsewhere on the board
A5: U103.35 (A5); also elsewhere on the board
A6: U103.36 (A6); also elsewhere on the board
A7: U103.37 (A7); also elsewhere on the board
A8: U103.38 (A8); also elsewhere on the board
A9: U103.39 (A9); also elsewhere on the board
A10: U103.40 (A10); also elsewhere on the board
A11: U103.1 (A11); also elsewhere on the board
A12: U103.2 (A12); also elsewhere on the board
A13: U103.3 (A13); also elsewhere on the board
BUSACK: U103.23 (~BUSACK); also elsewhere on the board
BUSRQ: R105.1, U103.25 (~BUSRQ); also elsewhere on the board
CLK: U103.6 (~CLK); also elsewhere on the board
CPU_A14: U103.4 (A14); also elsewhere on the board
CPU_A15: U103.5 (A15); also elsewhere on the board
D0: U103.14 (D0); also elsewhere on the board
D1: U103.15 (D1); also elsewhere on the board
D2: U103.12 (D2); also elsewhere on the board
D3: U103.8 (D3); also elsewhere on the board
D4: U103.7 (D4); also elsewhere on the board
D5: U103.9 (D5); also elsewhere on the board
D6: U103.10 (D6); also elsewhere on the board
D7: U103.13 (D7); also elsewhere on the board
GND: C101.2, C102.2, C103.2, C105.2, C106.2, C107.2, J101.2, J101.3, J102.2, R101.1, U101.2 (GND), U102.4 (GND), U103.29 (GND); also elsewhere on the board
HALT: U103.18 (~HALT); also elsewhere on the board
INT: R103.1, U103.16 (~INT); also elsewhere on the board
IORQ: U103.20 (~IORQ); also elsewhere on the board
M1: U103.27 (~M1); also elsewhere on the board
MREQ: U103.19 (~MREQ); also elsewhere on the board
NMI: U103.17 (~NMI); also elsewhere on the board
unnamed: C105.1, U102.1 (REF)
unnamed: C106.1, U102.3 (CT)
unnamed: R101.2, U102.6 (RESET)
RD: U103.21 (~RD); also elsewhere on the board
RESIN: U102.2 (~RESIN); also elsewhere on the board
RFSH: U103.28 (~RFSH); also elsewhere on the board
RST: R102.2, U102.5 (~RESET), U103.26 (~RESET); also elsewhere on the board
WAIT: R104.1, U103.24 (~WAIT); also elsewhere on the board
WR: U103.22 (~WR); also elsewhere on the board

Notes on the sheet:
for devices requiring another voltage
Power
A4-A7 selects these
This has to dissipate 4*I watts Remember heatsink
9VDC 2A
CLOCK
MMU
20Mhz, 2.5Mhz, or manual stepping
SEVEN SEGMENT
CPU
32k ROM Bank $01 - $02 512k RAM Bank $E0 - $FF

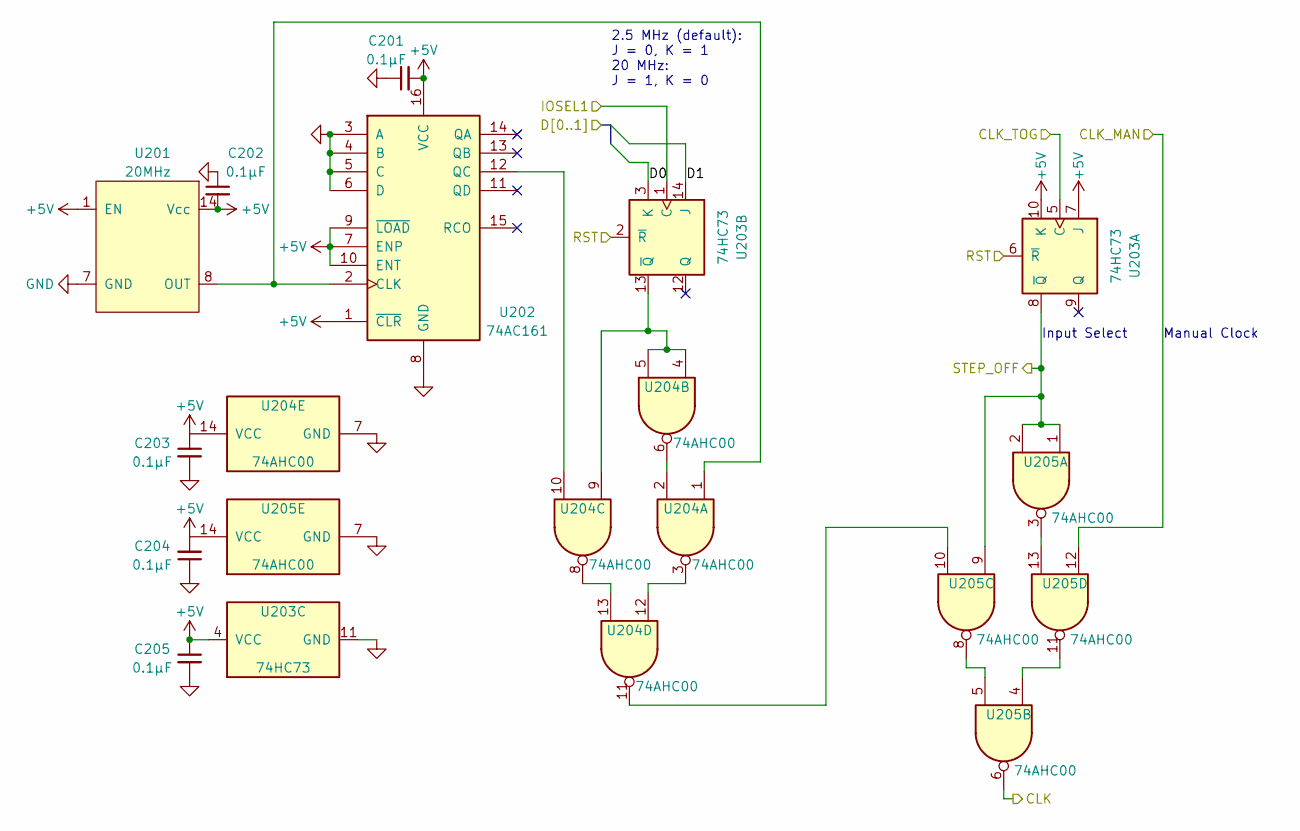
[picture p21: schematic clock.kicad_sch, Computer]

Parts:
C201, C202, C203, C204, C205: 0.1µF; C_Disc_D5.0mm_W2.5mm_P2.50mm
U201: 20MHz; DIP-14_W7.62mm_Socket_LongPads
U202: 74AC161; DIP-16_W7.62mm_Socket_LongPads
U203: 74HC73; DIP-14_W7.62mm_Socket_LongPads
U204, U205: 74AHC00; DIP-14_W7.62mm_Socket_LongPads

Connections:
+5V: C201.2, C202.2, C203.1, C204.2, C205.1, U201.1 (EN), U201.14 (Vcc), U202.1 (~CLR), U202.7 (ENP), U202.9 (~LOAD), U202.10 (ENT), U202.16 (VCC), U203.4 (VCC), U203.7 (J), U203.10 (K), U204.14 (VCC), U205.14 (VCC); also elsewhere on the board
/CLOCK/CLK_MAN: U205.12; also elsewhere on the board
/CLOCK/CLK_TOG: U203.5 (C); also elsewhere on the board
/CLOCK/STEP_OFF: U203.8 (~Q), U205.1, U205.2, U205.9; also elsewhere on the board
CLK: U205.6; also elsewhere on the board
D0: U203.3 (K); also elsewhere on the board
D1: U203.14 (J); also elsewhere on the board
GND: C201.1, C202.1, C203.2, C204.1, C205.2, U201.7 (GND), U202.3 (A), U202.4 (B), U202.5 (C), U202.6 (D), U202.8 (GND), U203.11 (GND), U204.7 (GND), U205.7 (GND); also elsewhere on the board
IOSEL1: U203.1 (C); also elsewhere on the board
unnamed: U201.8 (OUT), U202.2 (CLK), U204.1
unnamed: U202.12 (QC), U204.10
unnamed: U203.13 (~Q), U204.4, U204.5, U204.9
unnamed: U204.2, U204.6
unnamed: U204.11, U205.10
unnamed: U204.3, U204.12
unnamed: U204.8, U204.13
unnamed: U205.5, U205.8
unnamed: U205.4, U205.11
unnamed: U205.3, U205.13
RST: U203.2 (~R), U203.6 (~R); also elsewhere on the board

Notes on the sheet:
Manual Clock
2.5 MHz (default): J = 0, K = 1 20 MHz: J = 1, K = 0
Input Select

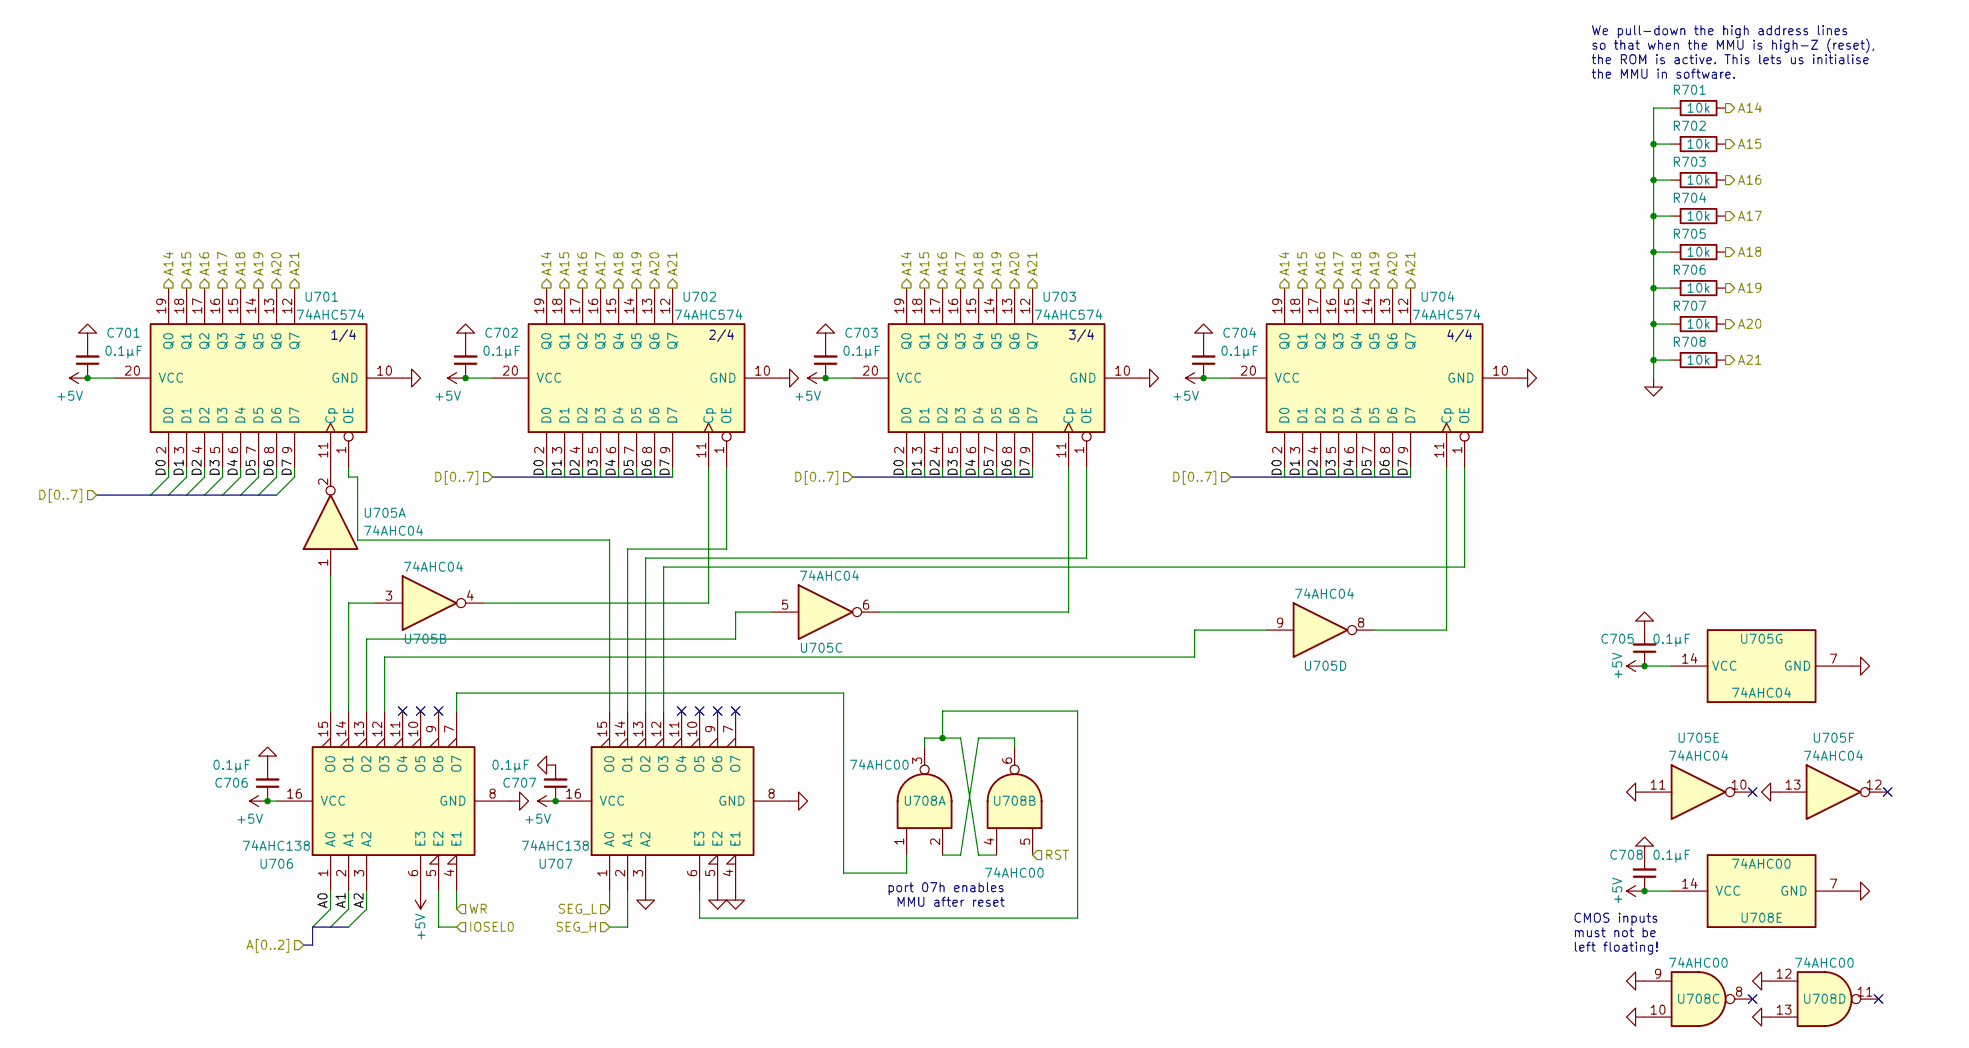
[picture p22: schematic mmu.kicad_sch, Computer]

Parts:
C701, C702, C703, C704, C705, C706, C707, C708: 0.1µF; C_Disc_D5.0mm_W2.5mm_P2.50mm
R701, R702, R703, R704, R705, R706, R707, R708: 10k; R_Axial_DIN0207_L6.3mm_D2.5mm_P10.16mm_Horizontal
U701, U702, U703, U704: 74AHC574; DIP-20_W7.62mm_Socket_LongPads
U705: 74AHC04; DIP-14_W7.62mm_Socket_LongPads
U706, U707: 74AHC138; DIP-16_W7.62mm_Socket_LongPads
U708: 74AHC00; DIP-14_W7.62mm_Socket_LongPads

Connections:
+5V: C701.1, C702.1, C703.1, C704.1, C705.1, C706.1, C707.1, C708.1, U701.20 (VCC), U702.20 (VCC), U703.20 (VCC), U704.20 (VCC), U705.14 (VCC), U706.6 (E3), U706.16 (VCC), U707.16 (VCC), U708.14 (VCC); also elsewhere on the board
A0: U706.1 (A0); also elsewhere on the board
A1: U706.2 (A1); also elsewhere on the board
A2: U706.3 (A2); also elsewhere on the board
A14: R701.1, U701.19 (Q0), U702.19 (Q0), U703.19 (Q0), U704.19 (Q0); also elsewhere on the board
A15: R702.1, U701.18 (Q1), U702.18 (Q1), U703.18 (Q1), U704.18 (Q1); also elsewhere on the board
A16: R703.1, U701.17 (Q2), U702.17 (Q2), U703.17 (Q2), U704.17 (Q2); also elsewhere on the board
A17: R704.1, U701.16 (Q3), U702.16 (Q3), U703.16 (Q3), U704.16 (Q3); also elsewhere on the board
A18: R705.1, U701.15 (Q4), U702.15 (Q4), U703.15 (Q4), U704.15 (Q4); also elsewhere on the board
A19: R706.1, U701.14 (Q5), U702.14 (Q5), U703.14 (Q5), U704.14 (Q5); also elsewhere on the board
A20: R707.1, U701.13 (Q6), U702.13 (Q6), U703.13 (Q6), U704.13 (Q6); also elsewhere on the board
A21: R708.1, U701.12 (Q7), U702.12 (Q7), U703.12 (Q7), U704.12 (Q7); also elsewhere on the board
CPU_A14: U707.1 (A0); also elsewhere on the board
CPU_A15: U707.2 (A1); also elsewhere on the board
D0: U701.2 (D0), U702.2 (D0), U703.2 (D0), U704.2 (D0); also elsewhere on the board
D1: U701.3 (D1), U702.3 (D1), U703.3 (D1), U704.3 (D1); also elsewhere on the board
D2: U701.4 (D2), U702.4 (D2), U703.4 (D2), U704.4 (D2); also elsewhere on the board
D3: U701.5 (D3), U702.5 (D3), U703.5 (D3), U704.5 (D3); also elsewhere on the board
D4: U701.6 (D4), U702.6 (D4), U703.6 (D4), U704.6 (D4); also elsewhere on the board
D5: U701.7 (D5), U702.7 (D5), U703.7 (D5), U704.7 (D5); also elsewhere on the board
D6: U701.8 (D6), U702.8 (D6), U703.8 (D6), U704.8 (D6); also elsewhere on the board
D7: U701.9 (D7), U702.9 (D7), U703.9 (D7), U704.9 (D7); also elsewhere on the board
GND: C701.2, C702.2, C703.2, C704.2, C705.2, C706.2, C707.2, C708.2, R701.2, R702.2, R703.2, R704.2, R705.2, R706.2, R707.2, R708.2, U701.10 (GND), U702.10 (GND), U703.10 (GND), U704.10 (GND), U705.7 (GND), U705.11, U705.13, U706.8 (GND), U707.3 (A2), U707.4 (E1), U707.5 (E2), U707.8 (GND), U708.7 (GND), U708.9, U708.10, U708.12, U708.13; also elsewhere on the board
IOSEL0: U706.5 (E2); also elsewhere on the board
unnamed: U701.1 (OE), U707.15 (O0)
unnamed: U701.11 (Cp), U705.2
unnamed: U702.1 (OE), U707.14 (O1)
unnamed: U702.11 (Cp), U705.4
unnamed: U703.1 (OE), U707.13 (O2)
unnamed: U703.11 (Cp), U705.6
unnamed: U704.1 (OE), U707.12 (O3)
unnamed: U704.11 (Cp), U705.8
unnamed: U705.1, U706.15 (O0)
unnamed: U705.3, U706.14 (O1)
unnamed: U705.5, U706.13 (O2)
unnamed: U705.9, U706.12 (O3)
unnamed: U706.7 (O7), U708.1
unnamed: U707.6 (E3), U708.3, U708.4
unnamed: U708.2, U708.6
RST: U708.5; also elsewhere on the board
WR: U706.4 (E1); also elsewhere on the board

Notes on the sheet:
1/4
4/4
2/4
We pull-down the high address lines so that when the MMU is high-Z (reset), the ROM is active. This lets us initialise the MMU in software.
port 07h enables MMU after reset
CMOS inputs must not be left floating!
3/4
