bailwillharr/thecomputer/computer/computer.kicad_pcb

## KiCad design computer/computer.kicad_pcb (continued)

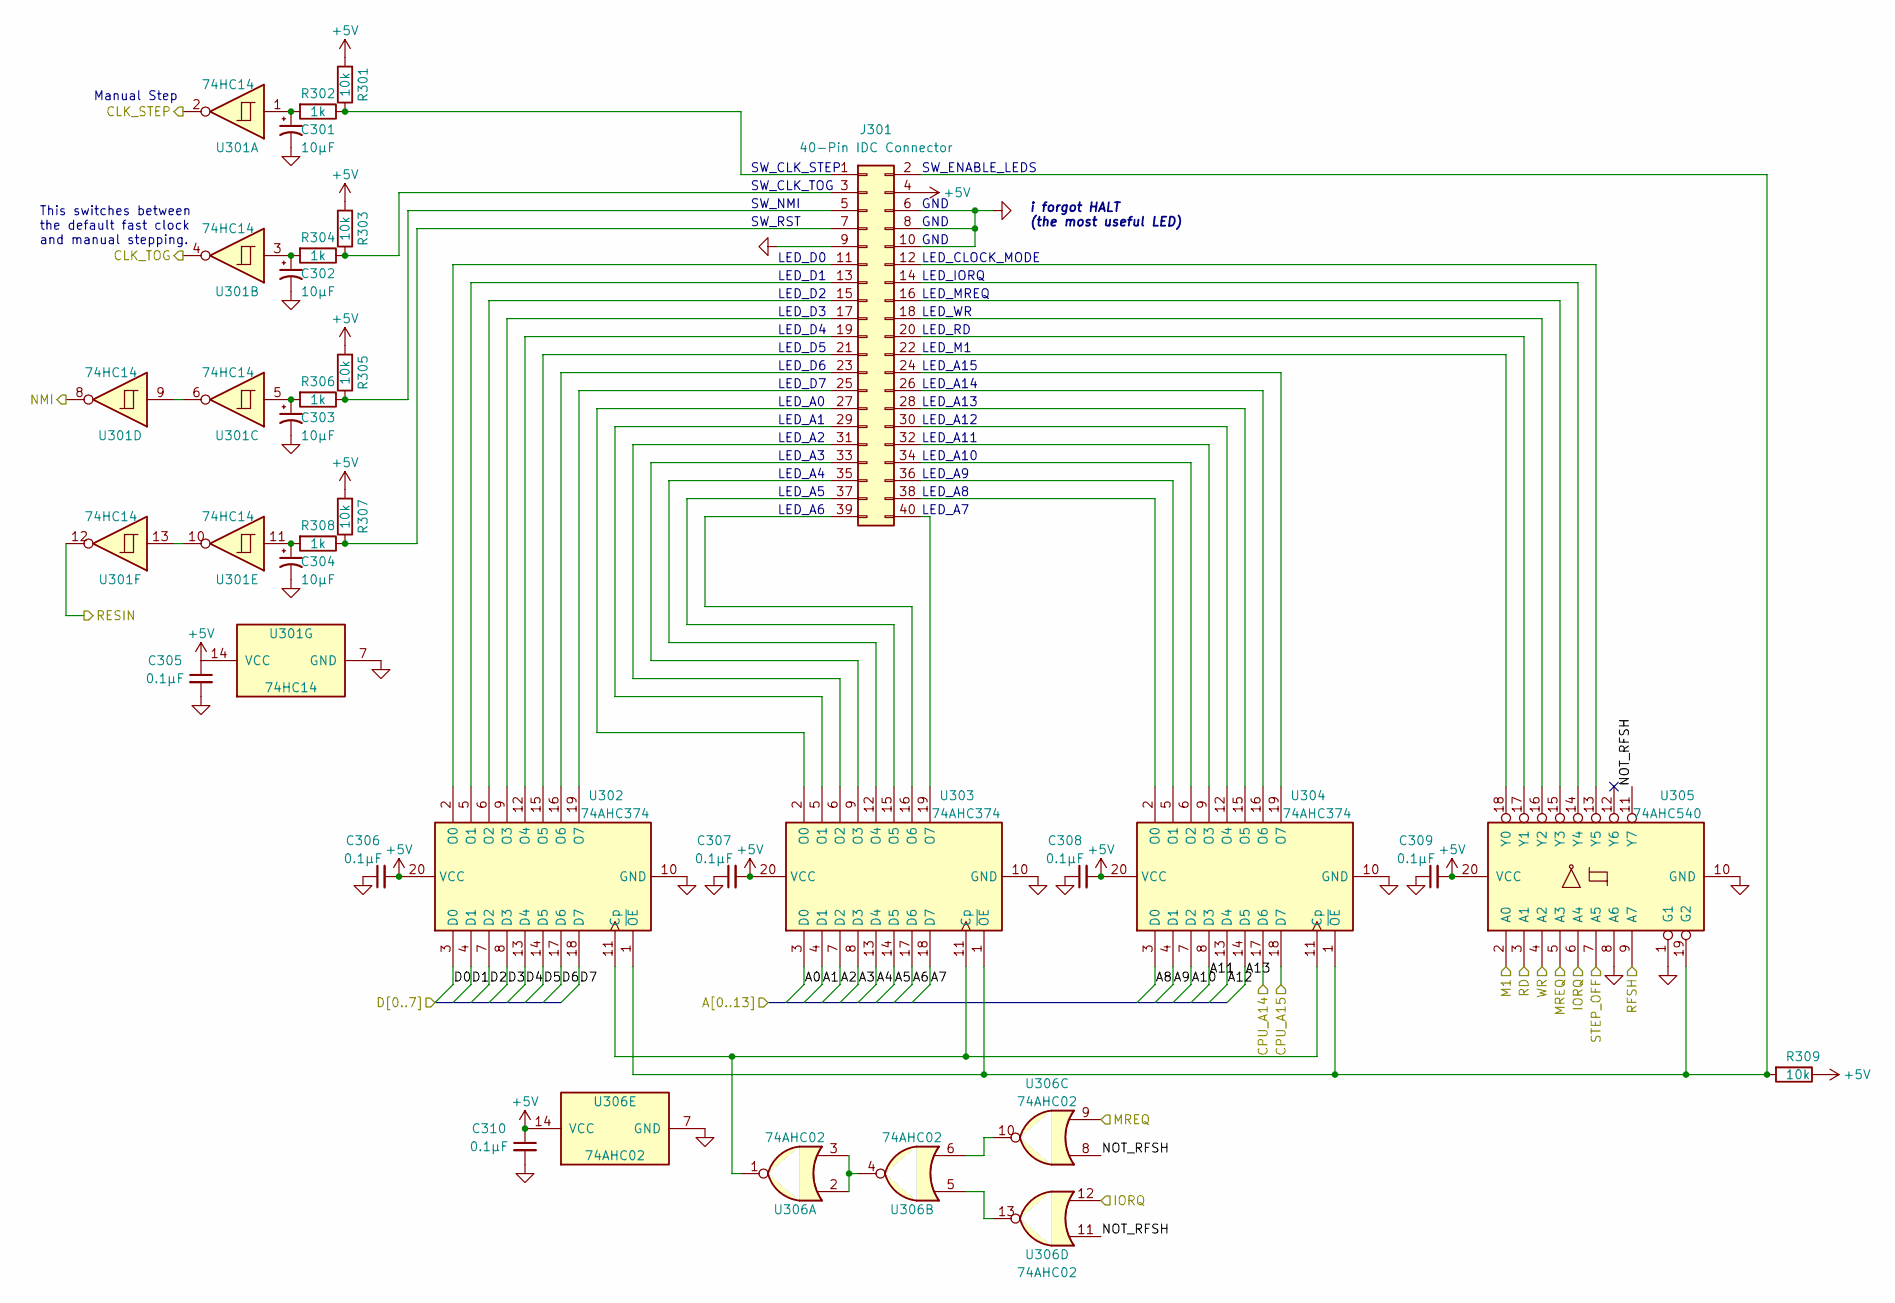
[picture p23: schematic front_panel.kicad_sch, Computer]

Parts:
C301, C302, C303, C304: 10µF; CP_Radial_D5.0mm_P2.50mm
C305, C306, C307, C308, C309, C310: 0.1µF; C_Disc_D5.0mm_W2.5mm_P2.50mm
J301: 40-Pin IDC Connector; IDC-Header_2x20_P2.54mm_Vertical
R301, R303, R305, R307, R309: 10k; R_Axial_DIN0207_L6.3mm_D2.5mm_P10.16mm_Horizontal
R302, R304, R306, R308: 1k; R_Axial_DIN0207_L6.3mm_D2.5mm_P10.16mm_Horizontal
U301: 74HC14; DIP-14_W7.62mm_Socket_LongPads
U302, U303, U304: 74AHC374; DIP-20_W7.62mm_Socket_LongPads
U305: 74AHC540; DIP-20_W7.62mm_Socket_LongPads
U306: 74AHC02; DIP-14_W7.62mm_Socket_LongPads

Connections:
+5V: C305.1, C306.2, C307.2, C308.2, C309.2, C310.1, J301.4, R301.2, R303.2, R305.2, R307.2, R309.1, U301.14 (VCC), U302.20 (VCC), U303.20 (VCC), U304.20 (VCC), U305.20 (VCC), U306.14 (VCC); also elsewhere on the board
/CLOCK/CLK_MAN: U301.2; also elsewhere on the board
/CLOCK/CLK_TOG: U301.4; also elsewhere on the board
/CLOCK/STEP_OFF: U305.7 (A5); also elsewhere on the board
/FRONT_PANEL/NOT_RFSH: U305.11 (Y7), U306.8, U306.11
A0: U303.3 (D0); also elsewhere on the board
A1: U303.4 (D1); also elsewhere on the board
A2: U303.7 (D2); also elsewhere on the board
A3: U303.8 (D3); also elsewhere on the board
A4: U303.13 (D4); also elsewhere on the board
A5: U303.14 (D5); also elsewhere on the board
A6: U303.17 (D6); also elsewhere on the board
A7: U303.18 (D7); also elsewhere on the board
A8: U304.3 (D0); also elsewhere on the board
A9: U304.4 (D1); also elsewhere on the board
A10: U304.7 (D2); also elsewhere on the board
A11: U304.8 (D3); also elsewhere on the board
A12: U304.13 (D4); also elsewhere on the board
A13: U304.14 (D5); also elsewhere on the board
CPU_A14: U304.17 (D6); also elsewhere on the board
CPU_A15: U304.18 (D7); also elsewhere on the board
D0: U302.3 (D0); also elsewhere on the board
D1: U302.4 (D1); also elsewhere on the board
D2: U302.7 (D2); also elsewhere on the board
D3: U302.8 (D3); also elsewhere on the board
D4: U302.13 (D4); also elsewhere on the board
D5: U302.14 (D5); also elsewhere on the board
D6: U302.17 (D6); also elsewhere on the board
D7: U302.18 (D7); also elsewhere on the board
GND: C301.2, C302.2, C303.2, C304.2, C305.2, C306.1, C307.1, C308.1, C309.1, C310.2, J301.6, J301.8, J301.9, J301.10, U301.7 (GND), U302.10 (GND), U303.10 (GND), U304.10 (GND), U305.1 (G1), U305.8 (A6), U305.10 (GND), U306.7 (GND); also elsewhere on the board
IORQ: U305.6 (A4), U306.12; also elsewhere on the board
M1: U305.2 (A0); also elsewhere on the board
MREQ: U305.5 (A3), U306.9; also elsewhere on the board
NMI: U301.8; also elsewhere on the board
unnamed: C301.1, R302.2, U301.1
unnamed: C302.1, R304.2, U301.3
unnamed: C303.1, R306.2, U301.5
unnamed: C304.1, R308.2, U301.11
unnamed: J301.1, R301.1, R302.1
unnamed: J301.2, R309.2, U302.1 (~OE), U303.1 (~OE), U304.1 (~OE), U305.19 (G2)
unnamed: J301.3, R303.1, R304.1
unnamed: J301.5, R305.1, R306.1
unnamed: J301.7, R307.1, R308.1
unnamed: J301.11, U302.2 (O0)
unnamed: J301.12, U305.13 (Y5)
unnamed: J301.13, U302.5 (O1)
unnamed: J301.14, U305.14 (Y4)
unnamed: J301.15, U302.6 (O2)
unnamed: J301.16, U305.15 (Y3)
unnamed: J301.17, U302.9 (O3)
unnamed: J301.18, U305.16 (Y2)
unnamed: J301.19, U302.12 (O4)
unnamed: J301.20, U305.17 (Y1)
unnamed: J301.21, U302.15 (O5)
unnamed: J301.22, U305.18 (Y0)
unnamed: J301.23, U302.16 (O6)
unnamed: J301.24, U304.19 (O7)
unnamed: J301.25, U302.19 (O7)
unnamed: J301.26, U304.16 (O6)
unnamed: J301.27, U303.2 (O0)
unnamed: J301.28, U304.15 (O5)
unnamed: J301.29, U303.5 (O1)
unnamed: J301.30, U304.12 (O4)
unnamed: J301.31, U303.6 (O2)
unnamed: J301.32, U304.9 (O3)
unnamed: J301.33, U303.9 (O3)
unnamed: J301.34, U304.6 (O2)
unnamed: J301.35, U303.12 (O4)
unnamed: J301.36, U304.5 (O1)
unnamed: J301.37, U303.15 (O5)
unnamed: J301.38, U304.2 (O0)
unnamed: J301.39, U303.16 (O6)
unnamed: J301.40, U303.19 (O7)
unnamed: U301.6, U301.9
unnamed: U301.10, U301.13
unnamed: U302.11 (Cp), U303.11 (Cp), U304.11 (Cp), U306.1
unnamed: U306.2, U306.3, U306.4
unnamed: U306.6, U306.10
unnamed: U306.5, U306.13
RD: U305.3 (A1); also elsewhere on the board
RESIN: U301.12; also elsewhere on the board
RFSH: U305.9 (A7); also elsewhere on the board
WR: U305.4 (A2); also elsewhere on the board

Notes on the sheet:
LED_D7
LED_A8
LED_A15
LED_A11
LED_D6
LED_A13
LED_D5
LED_A10
LED_D0
LED_D2
LED_D1
GND
LED_A0
SW_CLK_STEP
i forgot HALT (the most useful LED)
LED_A9
LED_D3
LED_A1
LED_MREQ
LED_WR
LED_M1
LED_A3
This switches between the default fast clock and manual stepping.
LED_RD
LED_A4
SW_ENABLE_LEDS
LED_IORQ
LED_CLOCK_MODE
LED_A6
SW_NMI
SW_CLK_TOG
LED_A12
LED_D4
Manual Step
LED_A2
LED_A5
SW_RST
LED_A14
LED_A7

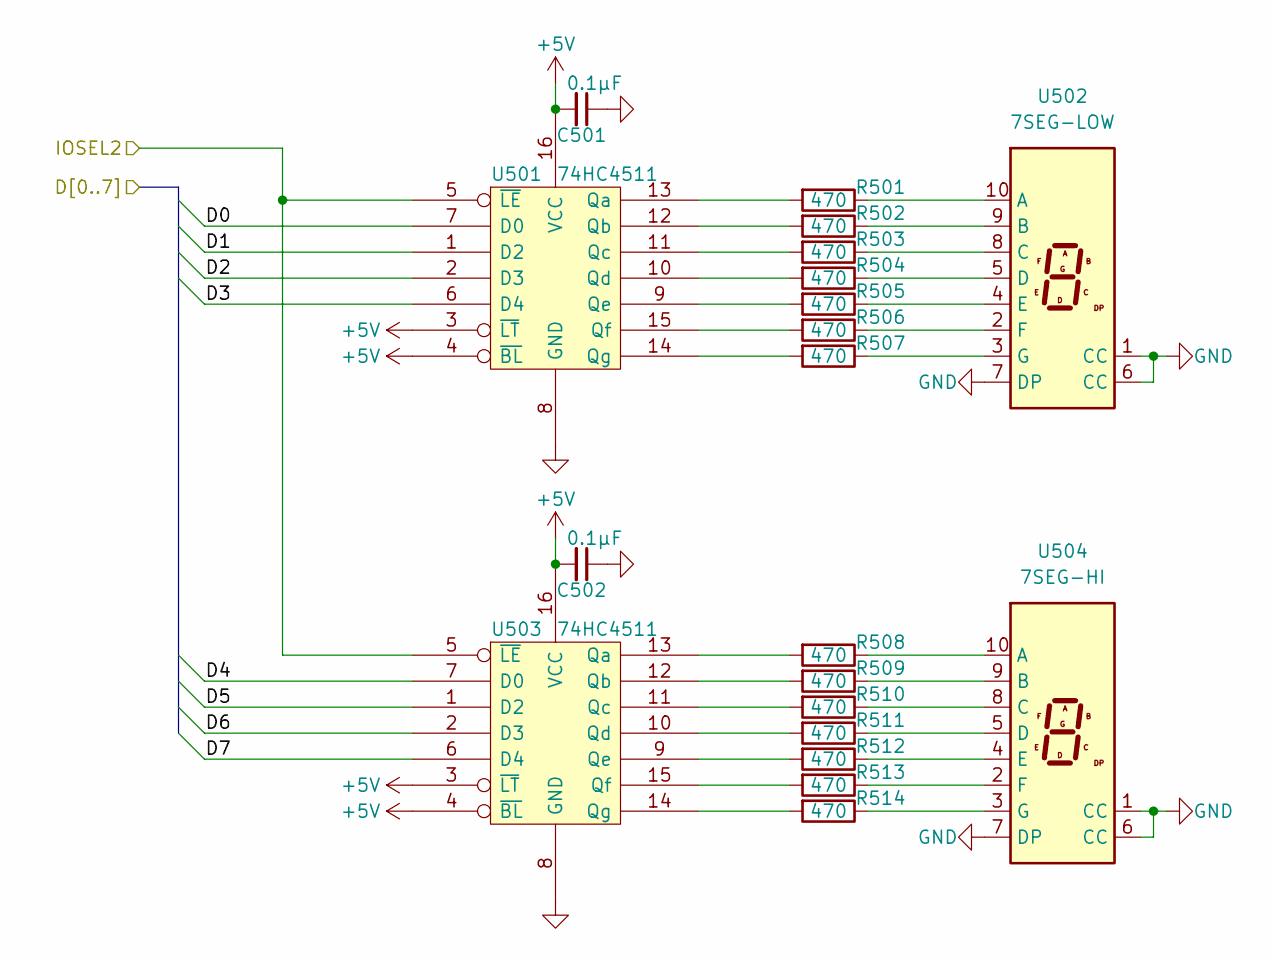
[picture p24: schematic seven_segment.kicad_sch, Computer]

Parts:
C501, C502: 0.1µF; C_Disc_D5.0mm_W2.5mm_P2.50mm
R501, R502, R503, R504, R505, R506, R507, R508, R509, R510, R511, R512, R513, R514: 470; R_Axial_DIN0207_L6.3mm_D2.5mm_P10.16mm_Horizontal
U501, U503: 74HC4511; DIP-16_W7.62mm_Socket_LongPads
U502: 7SEG-LOW; HDSP-A151
U504: 7SEG-HI; HDSP-A151

Connections:
+5V: C501.2, C502.2, U501.3 (~LT), U501.4 (~BL), U501.16 (VCC), U503.3 (~LT), U503.4 (~BL), U503.16 (VCC); also elsewhere on the board
D0: U501.7 (D0); also elsewhere on the board
D1: U501.1 (D2); also elsewhere on the board
D2: U501.2 (D3); also elsewhere on the board
D3: U501.6 (D4); also elsewhere on the board
D4: U503.7 (D0); also elsewhere on the board
D5: U503.1 (D2); also elsewhere on the board
D6: U503.2 (D3); also elsewhere on the board
D7: U503.6 (D4); also elsewhere on the board
GND: C501.1, C502.1, U501.8 (GND), U502.1 (CC), U502.6 (CC), U502.7 (DP), U503.8 (GND), U504.1 (CC), U504.6 (CC), U504.7 (DP); also elsewhere on the board
IOSEL2: U501.5 (~LE), U503.5 (~LE); also elsewhere on the board
unnamed: R501.1, U502.10 (A)
unnamed: R501.2, U501.13 (Qa)
unnamed: R502.1, U502.9 (B)
unnamed: R502.2, U501.12 (Qb)
unnamed: R503.1, U502.8 (C)
unnamed: R503.2, U501.11 (Qc)
unnamed: R504.1, U502.5 (D)
unnamed: R504.2, U501.10 (Qd)
unnamed: R505.1, U502.4 (E)
unnamed: R505.2, U501.9 (Qe)
unnamed: R506.1, U502.2 (F)
unnamed: R506.2, U501.15 (Qf)
unnamed: R507.1, U502.3 (G)
unnamed: R507.2, U501.14 (Qg)
unnamed: R508.1, U504.10 (A)
unnamed: R508.2, U503.13 (Qa)
unnamed: R509.1, U504.9 (B)
unnamed: R509.2, U503.12 (Qb)
unnamed: R510.1, U504.8 (C)
unnamed: R510.2, U503.11 (Qc)
unnamed: R511.1, U504.5 (D)
unnamed: R511.2, U503.10 (Qd)
unnamed: R512.1, U504.4 (E)
unnamed: R512.2, U503.9 (Qe)
unnamed: R513.1, U504.2 (F)
unnamed: R513.2, U503.15 (Qf)
unnamed: R514.1, U504.3 (G)
unnamed: R514.2, U503.14 (Qg)

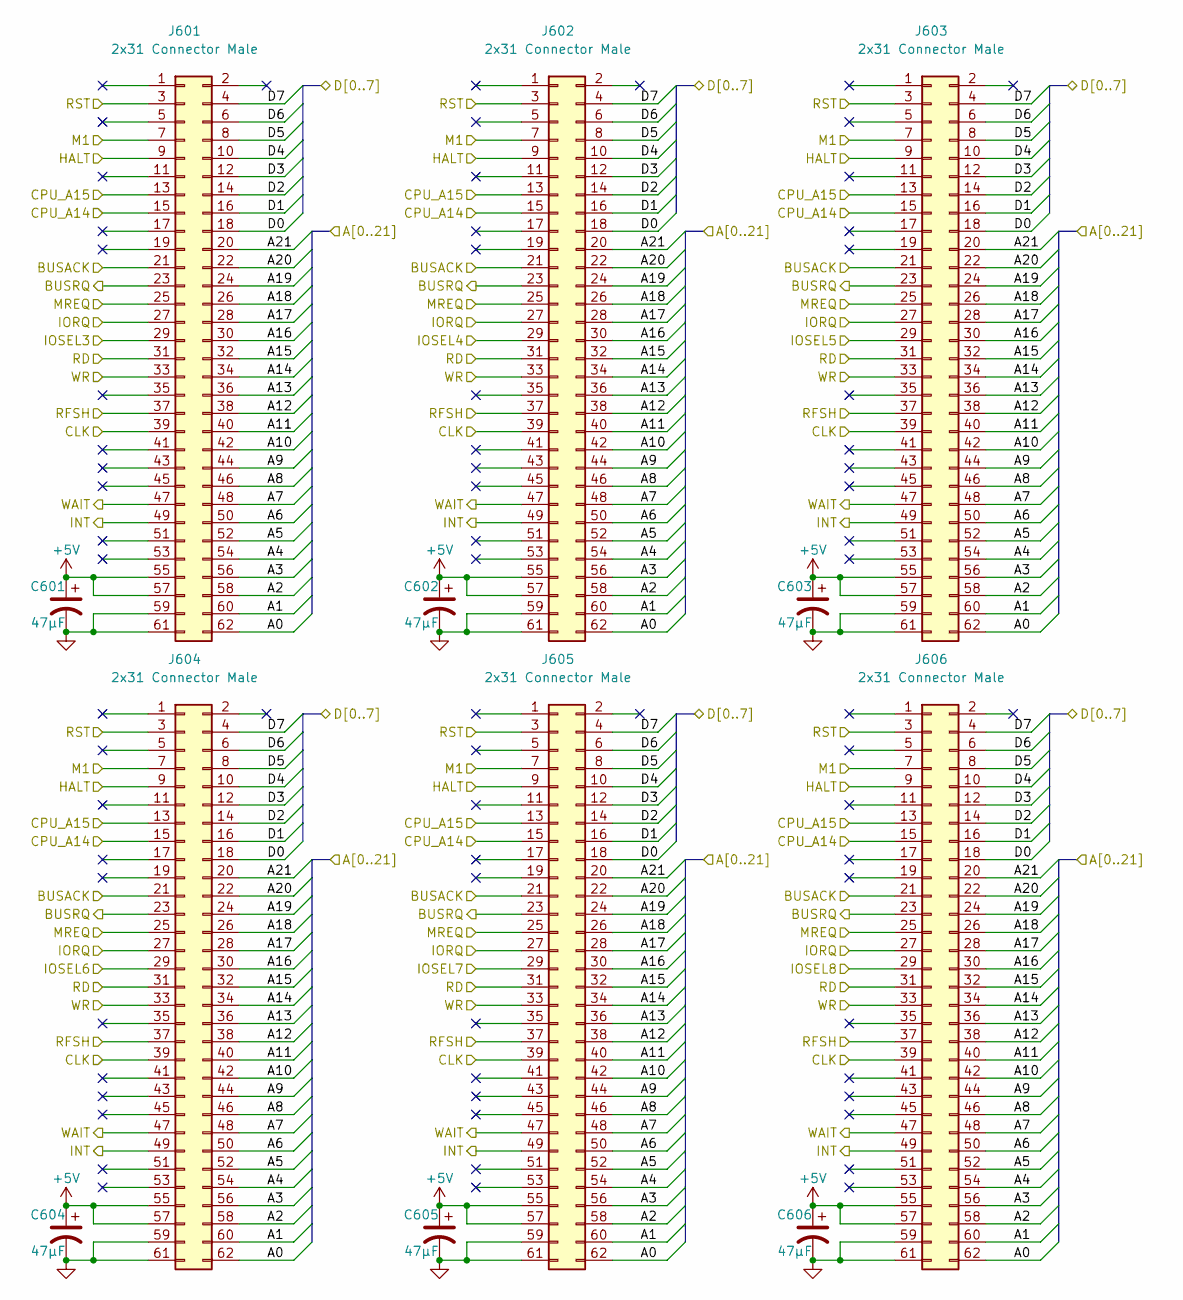
[picture p25: schematic card_interfaces.kicad_sch, Computer]

Parts:
C601, C602, C603, C604, C605, C606: 47µF; CP_Radial_D5.0mm_P2.50mm
J601, J602, J603, J604, J605, J606: 2x31 Connector Male; PinHeader_2x31_P2.54mm_Vertical

Connections:
+5V: C601.1, C602.1, C603.1, C604.1, C605.1, C606.1, J601.55, J601.57, J602.55, J602.57, J603.55, J603.57, J604.55, J604.57, J605.55, J605.57, J606.55, J606.57; also elsewhere on the board
A0: J601.62, J602.62, J603.62, J604.62, J605.62, J606.62; also elsewhere on the board
A1: J601.60, J602.60, J603.60, J604.60, J605.60, J606.60; also elsewhere on the board
A2: J601.58, J602.58, J603.58, J604.58, J605.58, J606.58; also elsewhere on the board
A3: J601.56, J602.56, J603.56, J604.56, J605.56, J606.56; also elsewhere on the board
A4: J601.54, J602.54, J603.54, J604.54, J605.54, J606.54; also elsewhere on the board
A5: J601.52, J602.52, J603.52, J604.52, J605.52, J606.52; also elsewhere on the board
A6: J601.50, J602.50, J603.50, J604.50, J605.50, J606.50; also elsewhere on the board
A7: J601.48, J602.48, J603.48, J604.48, J605.48, J606.48; also elsewhere on the board
A8: J601.46, J602.46, J603.46, J604.46, J605.46, J606.46; also elsewhere on the board
A9: J601.44, J602.44, J603.44, J604.44, J605.44, J606.44; also elsewhere on the board
A10: J601.42, J602.42, J603.42, J604.42, J605.42, J606.42; also elsewhere on the board
A11: J601.40, J602.40, J603.40, J604.40, J605.40, J606.40; also elsewhere on the board
A12: J601.38, J602.38, J603.38, J604.38, J605.38, J606.38; also elsewhere on the board
A13: J601.36, J602.36, J603.36, J604.36, J605.36, J606.36; also elsewhere on the board
A14: J601.34, J602.34, J603.34, J604.34, J605.34, J606.34; also elsewhere on the board
A15: J601.32, J602.32, J603.32, J604.32, J605.32, J606.32; also elsewhere on the board
A16: J601.30, J602.30, J603.30, J604.30, J605.30, J606.30; also elsewhere on the board
A17: J601.28, J602.28, J603.28, J604.28, J605.28, J606.28; also elsewhere on the board
A18: J601.26, J602.26, J603.26, J604.26, J605.26, J606.26; also elsewhere on the board
A19: J601.24, J602.24, J603.24, J604.24, J605.24, J606.24; also elsewhere on the board
A20: J601.22, J602.22, J603.22, J604.22, J605.22, J606.22; also elsewhere on the board
A21: J601.20, J602.20, J603.20, J604.20, J605.20, J606.20; also elsewhere on the board
BUSACK: J601.21, J602.21, J603.21, J604.21, J605.21, J606.21; also elsewhere on the board
BUSRQ: J601.23, J602.23, J603.23, J604.23, J605.23, J606.23; also elsewhere on the board
CLK: J601.39, J602.39, J603.39, J604.39, J605.39, J606.39; also elsewhere on the board
CPU_A14: J601.15, J602.15, J603.15, J604.15, J605.15, J606.15; also elsewhere on the board
CPU_A15: J601.13, J602.13, J603.13, J604.13, J605.13, J606.13; also elsewhere on the board
D0: J601.18, J602.18, J603.18, J604.18, J605.18, J606.18; also elsewhere on the board
D1: J601.16, J602.16, J603.16, J604.16, J605.16, J606.16; also elsewhere on the board
D2: J601.14, J602.14, J603.14, J604.14, J605.14, J606.14; also elsewhere on the board
D3: J601.12, J602.12, J603.12, J604.12, J605.12, J606.12; also elsewhere on the board
D4: J601.10, J602.10, J603.10, J604.10, J605.10, J606.10; also elsewhere on the board
D5: J601.8, J602.8, J603.8, J604.8, J605.8, J606.8; also elsewhere on the board
D6: J601.6, J602.6, J603.6, J604.6, J605.6, J606.6; also elsewhere on the board
D7: J601.4, J602.4, J603.4, J604.4, J605.4, J606.4; also elsewhere on the board
GND: C601.2, C602.2, C603.2, C604.2, C605.2, C606.2, J601.59, J601.61, J602.59, J602.61, J603.59, J603.61, J604.59, J604.61, J605.59, J605.61, J606.59, J606.61; also elsewhere on the board
HALT: J601.9, J602.9, J603.9, J604.9, J605.9, J606.9; also elsewhere on the board
INT: J601.49, J602.49, J603.49, J604.49, J605.49, J606.49; also elsewhere on the board
IORQ: J601.27, J602.27, J603.27, J604.27, J605.27, J606.27; also elsewhere on the board
IOSEL3: J601.29; also elsewhere on the board
IOSEL4: J602.29; also elsewhere on the board
IOSEL5: J603.29; also elsewhere on the board
IOSEL6: J604.29; also elsewhere on the board
IOSEL7: J605.29; also elsewhere on the board
IOSEL8: J606.29; also elsewhere on the board
M1: J601.7, J602.7, J603.7, J604.7, J605.7, J606.7; also elsewhere on the board
MREQ: J601.25, J602.25, J603.25, J604.25, J605.25, J606.25; also elsewhere on the board
RD: J601.31, J602.31, J603.31, J604.31, J605.31, J606.31; also elsewhere on the board
RFSH: J601.37, J602.37, J603.37, J604.37, J605.37, J606.37; also elsewhere on the board
RST: J601.3, J602.3, J603.3, J604.3, J605.3, J606.3; also elsewhere on the board
WAIT: J601.47, J602.47, J603.47, J604.47, J605.47, J606.47; also elsewhere on the board
WR: J601.33, J602.33, J603.33, J604.33, J605.33, J606.33; also elsewhere on the board

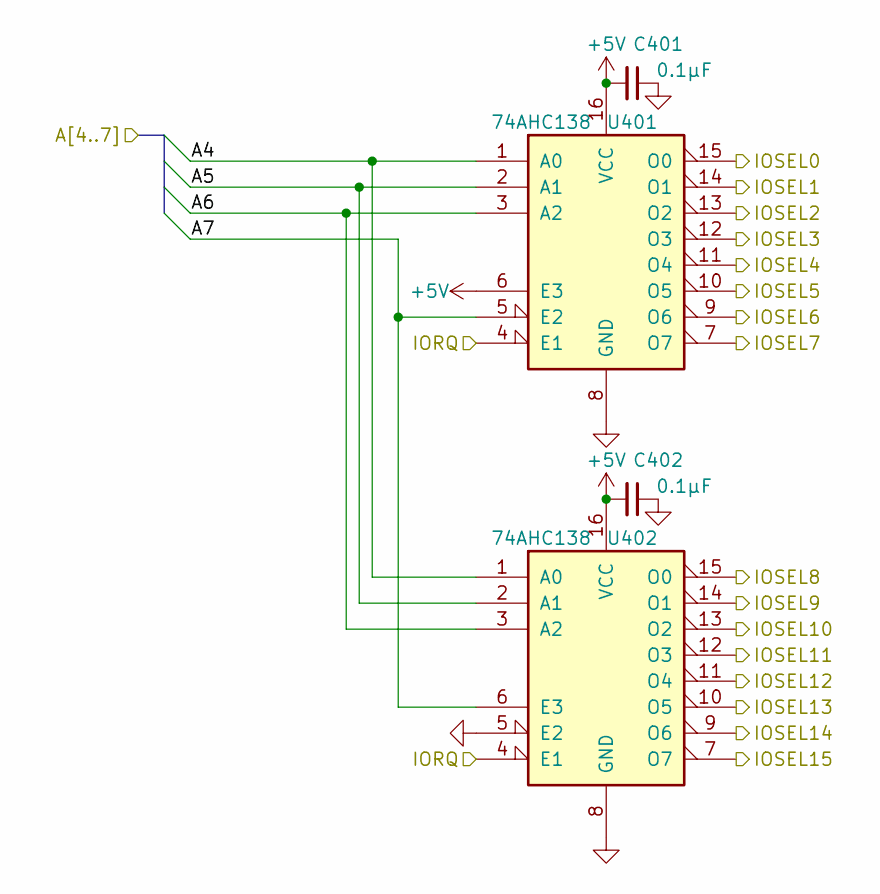
[picture p26: schematic io_decoder.kicad_sch, Computer]

Parts:
C401, C402: 0.1µF; C_Disc_D5.0mm_W2.5mm_P2.50mm
U401, U402: 74AHC138; DIP-16_W7.62mm_Socket_LongPads

Connections:
+5V: C401.2, C402.2, U401.6 (E3), U401.16 (VCC), U402.16 (VCC); also elsewhere on the board
A4: U401.1 (A0), U402.1 (A0); also elsewhere on the board
A5: U401.2 (A1), U402.2 (A1); also elsewhere on the board
A6: U401.3 (A2), U402.3 (A2); also elsewhere on the board
A7: U401.5 (E2), U402.6 (E3); also elsewhere on the board
GND: C401.1, C402.1, U401.8 (GND), U402.5 (E2), U402.8 (GND); also elsewhere on the board
IORQ: U401.4 (E1), U402.4 (E1); also elsewhere on the board
IOSEL0: U401.15 (O0); also elsewhere on the board
IOSEL1: U401.14 (O1); also elsewhere on the board
IOSEL2: U401.13 (O2); also elsewhere on the board
IOSEL3: U401.12 (O3); also elsewhere on the board
IOSEL4: U401.11 (O4); also elsewhere on the board
IOSEL5: U401.10 (O5); also elsewhere on the board
IOSEL6: U401.9 (O6); also elsewhere on the board
IOSEL7: U401.7 (O7); also elsewhere on the board
IOSEL8: U402.15 (O0); also elsewhere on the board

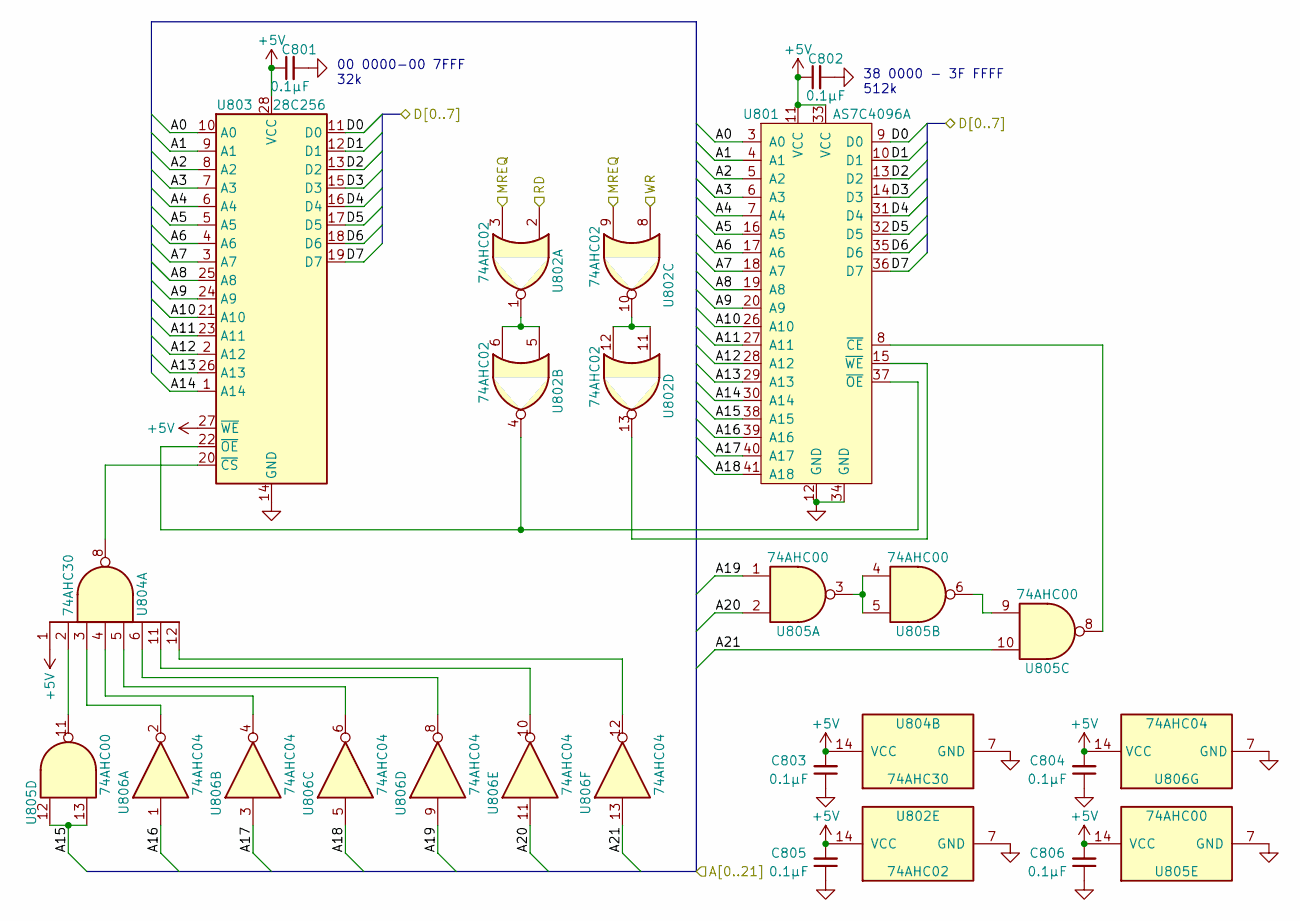
[picture p27: schematic ram_and_rom.kicad_sch, Computer]

Parts:
C801, C802, C803, C804, C805, C806: 0.1µF; C_Disc_D5.0mm_W2.5mm_P2.50mm
U801: AS7C4096A; TSOP-II-44_10.16x18.41mm_P0.8mm
U802: 74AHC02; DIP-14_W7.62mm_Socket_LongPads
U803: 28C256; DIP-28_W15.24mm_Socket_LongPads
U804: 74AHC30; DIP-14_W7.62mm_Socket_LongPads
U805: 74AHC00; DIP-14_W7.62mm_Socket_LongPads
U806: 74AHC04; DIP-14_W7.62mm_Socket_LongPads

Connections:
+5V: C801.1, C802.1, C803.2, C804.2, C805.2, C806.2, U801.11 (VCC), U801.33 (VCC), U802.14 (VCC), U803.27 (~WE), U803.28 (VCC), U804.1, U804.14 (VCC), U805.14 (VCC), U806.14 (VCC); also elsewhere on the board
A0: U801.3 (A0), U803.10 (A0); also elsewhere on the board
A1: U801.4 (A1), U803.9 (A1); also elsewhere on the board
A2: U801.5 (A2), U803.8 (A2); also elsewhere on the board
A3: U801.6 (A3), U803.7 (A3); also elsewhere on the board
A4: U801.7 (A4), U803.6 (A4); also elsewhere on the board
A5: U801.16 (A5), U803.5 (A5); also elsewhere on the board
A6: U801.17 (A6), U803.4 (A6); also elsewhere on the board
A7: U801.18 (A7), U803.3 (A7); also elsewhere on the board
A8: U801.19 (A8), U803.25 (A8); also elsewhere on the board
A9: U801.20 (A9), U803.24 (A9); also elsewhere on the board
A10: U801.26 (A10), U803.21 (A10); also elsewhere on the board
A11: U801.27 (A11), U803.23 (A11); also elsewhere on the board
A12: U801.28 (A12), U803.2 (A12); also elsewhere on the board
A13: U801.29 (A13), U803.26 (A13); also elsewhere on the board
A14: U801.30 (A14), U803.1 (A14); also elsewhere on the board
A15: U801.38 (A15), U805.12, U805.13; also elsewhere on the board
A16: U801.39 (A16), U806.1; also elsewhere on the board
A17: U801.40 (A17), U806.3; also elsewhere on the board
A18: U801.41 (A18), U806.5; also elsewhere on the board
A19: U805.1, U806.9; also elsewhere on the board
A20: U805.2, U806.11; also elsewhere on the board
A21: U805.10, U806.13; also elsewhere on the board
D0: U801.9 (D0), U803.11 (D0); also elsewhere on the board
D1: U801.10 (D1), U803.12 (D1); also elsewhere on the board
D2: U801.13 (D2), U803.13 (D2); also elsewhere on the board
D3: U801.14 (D3), U803.15 (D3); also elsewhere on the board
D4: U801.31 (D4), U803.16 (D4); also elsewhere on the board
D5: U801.32 (D5), U803.17 (D5); also elsewhere on the board
D6: U801.35 (D6), U803.18 (D6); also elsewhere on the board
D7: U801.36 (D7), U803.19 (D7); also elsewhere on the board
GND: C801.2, C802.2, C803.1, C804.1, C805.1, C806.1, U801.12 (GND), U801.34 (GND), U802.7 (GND), U803.14 (GND), U804.7 (GND), U805.7 (GND), U806.7 (GND); also elsewhere on the board
MREQ: U802.3, U802.9; also elsewhere on the board
unnamed: U801.8 (~CE), U805.8
unnamed: U801.15 (~WE), U802.13
unnamed: U801.37 (~OE), U802.4, U803.22 (~OE)
unnamed: U802.1, U802.5, U802.6
unnamed: U802.10, U802.11, U802.12
unnamed: U803.20 (~CS), U804.8
unnamed: U804.2, U805.11
unnamed: U804.3, U806.2
unnamed: U804.4, U806.4
unnamed: U804.5, U806.6
unnamed: U804.6, U806.8
unnamed: U804.11, U806.10
unnamed: U804.12, U806.12
unnamed: U805.3, U805.4, U805.5
unnamed: U805.6, U805.9
RD: U802.2; also elsewhere on the board
WR: U802.8; also elsewhere on the board

Notes on the sheet:
38 0000 - 3F FFFF 512k
00 0000-00 7FFF 32k

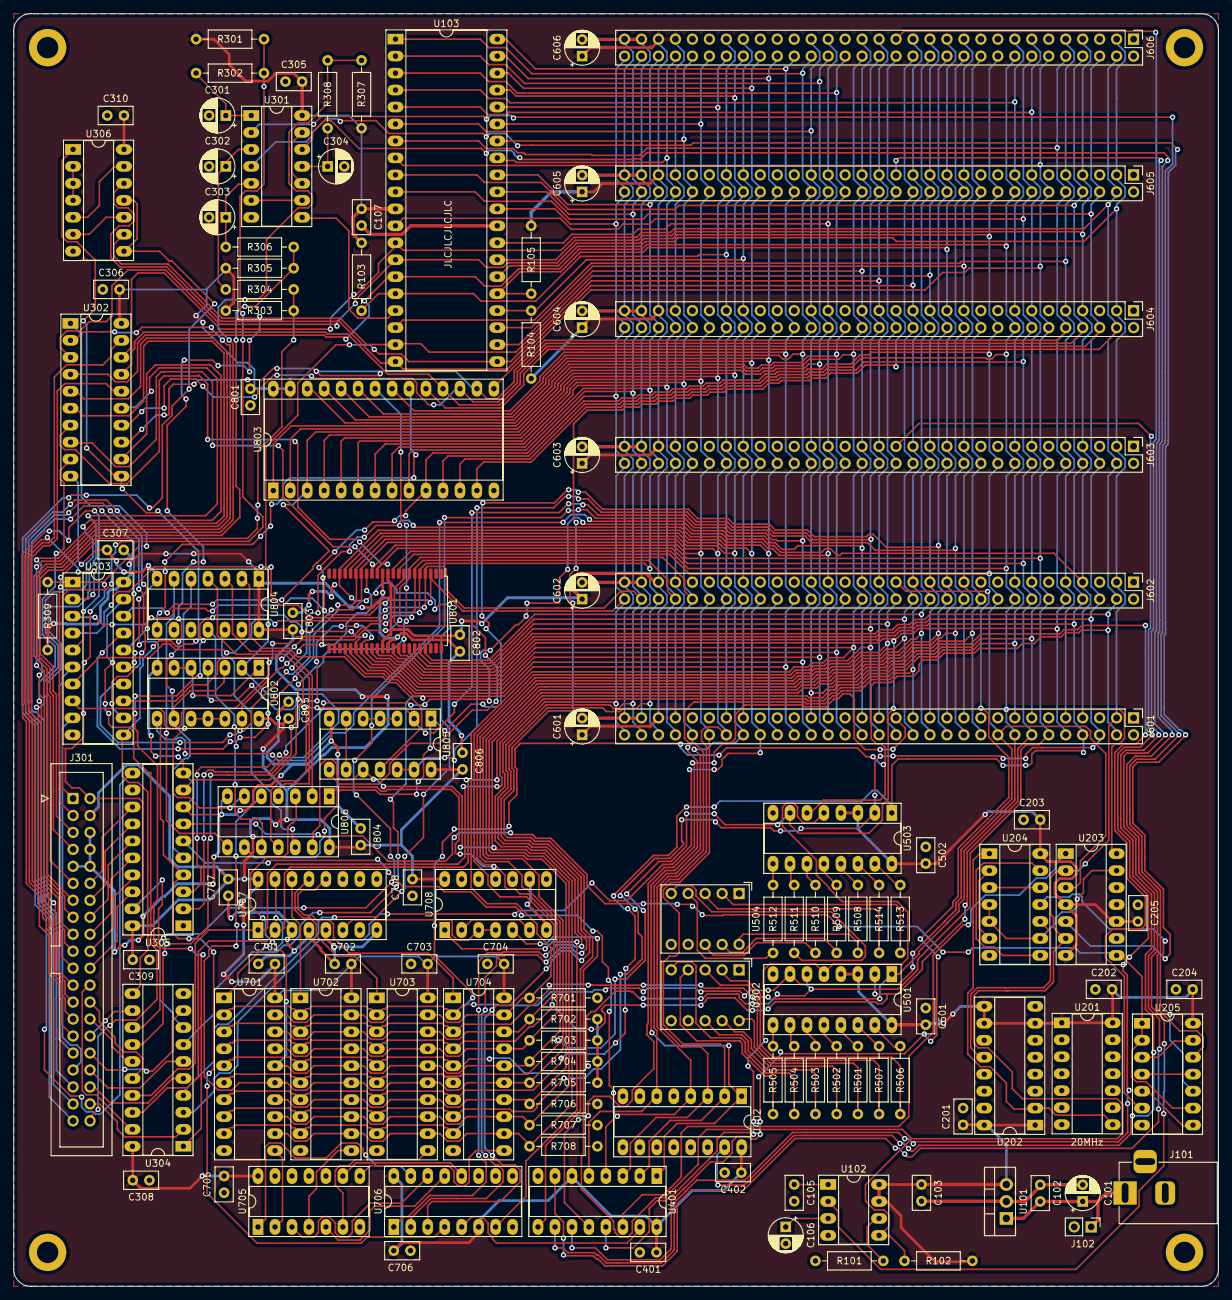
[picture p28: board computer.kicad_pcb from above]

Board: 2 copper layers, 180.3 x 190.5 mm, 124 parts (0 on the bottom side), 179 nets.
