bailwillharr/thecomputer/(commit log)

2023-03-08 Tidy up
    [dac.kicad_sch, dac.sch, framebuffer_addresses.xlsx, tile_logic.kicad_sch, timing.kicad_sch, timing.sch, video.kicad_pcb, video.kicad_sch]
2023-03-09 remove backups
    [video.kicad_pcb]
